die-mirarchi/Watchdog-IHP-SG13G2/design/blocks/bias/README.md

# Polarización analógica

Carpeta reservada. Diseño, dimensiones y arquitectura por definir por el autor.

- `schematic/`: esquemáticos y símbolos Xschem.
- `layout/`: layouts editables y entregables físicos.
- `char/`: configuración de caracterización, cuando exista un diseño.
