die-mirarchi/Watchdog-IHP-SG13G2/graphs/bias/ss/bias_ss_corriente_vs_VDD_y_T.png

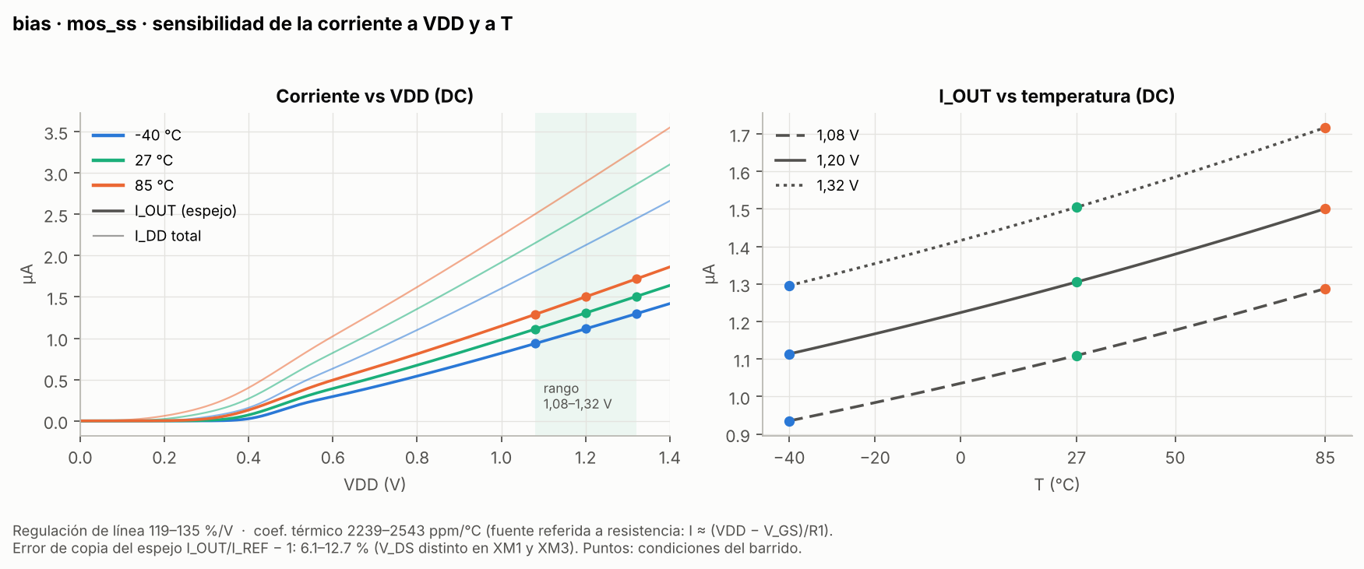
graphs/bias/ss/bias_ss_corriente_vs_VDD_y_T.png
