die-mirarchi/Watchdog-IHP-SG13G2/graphs/bias/ss/bias_ss_corrientes_arranque.png

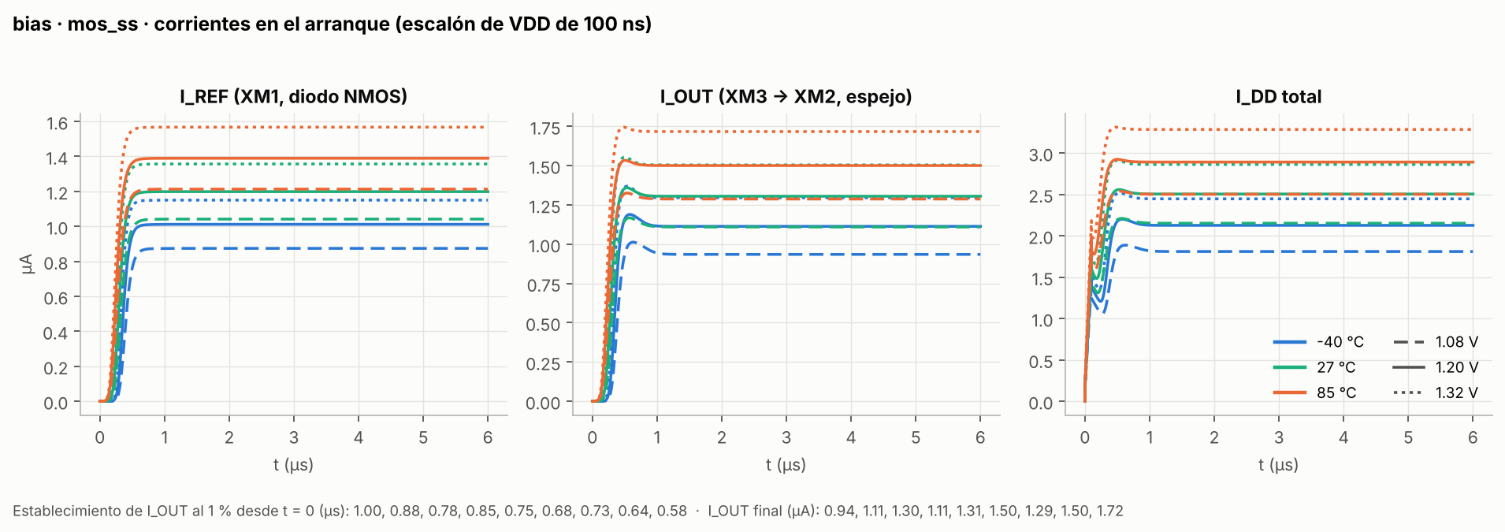
graphs/bias/ss/bias_ss_corrientes_arranque.png
