die-mirarchi/Watchdog-IHP-SG13G2/graphs/comp_inf/ss/comp_inf_ss_respuesta_temporal.png

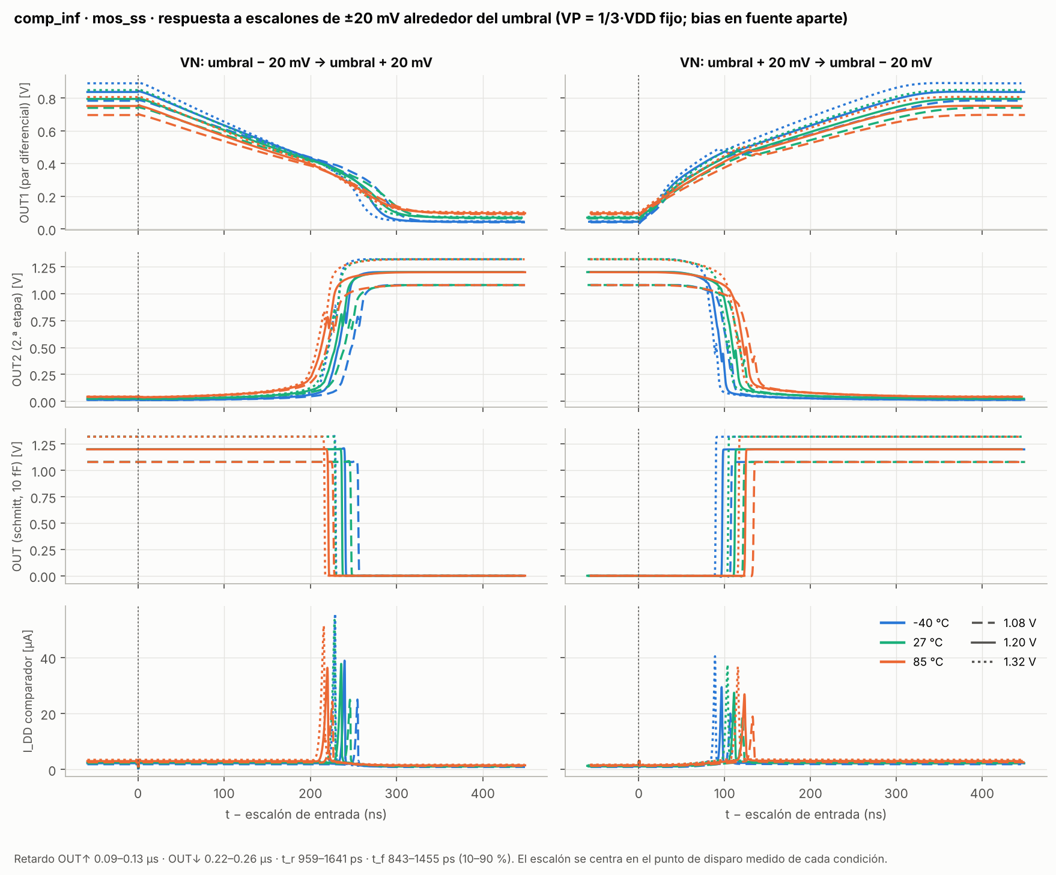
graphs/comp_inf/ss/comp_inf_ss_respuesta_temporal.png
