die-mirarchi/Watchdog-IHP-SG13G2/graphs/comp_inf/tt/comp_inf_tt_respuesta_temporal.png

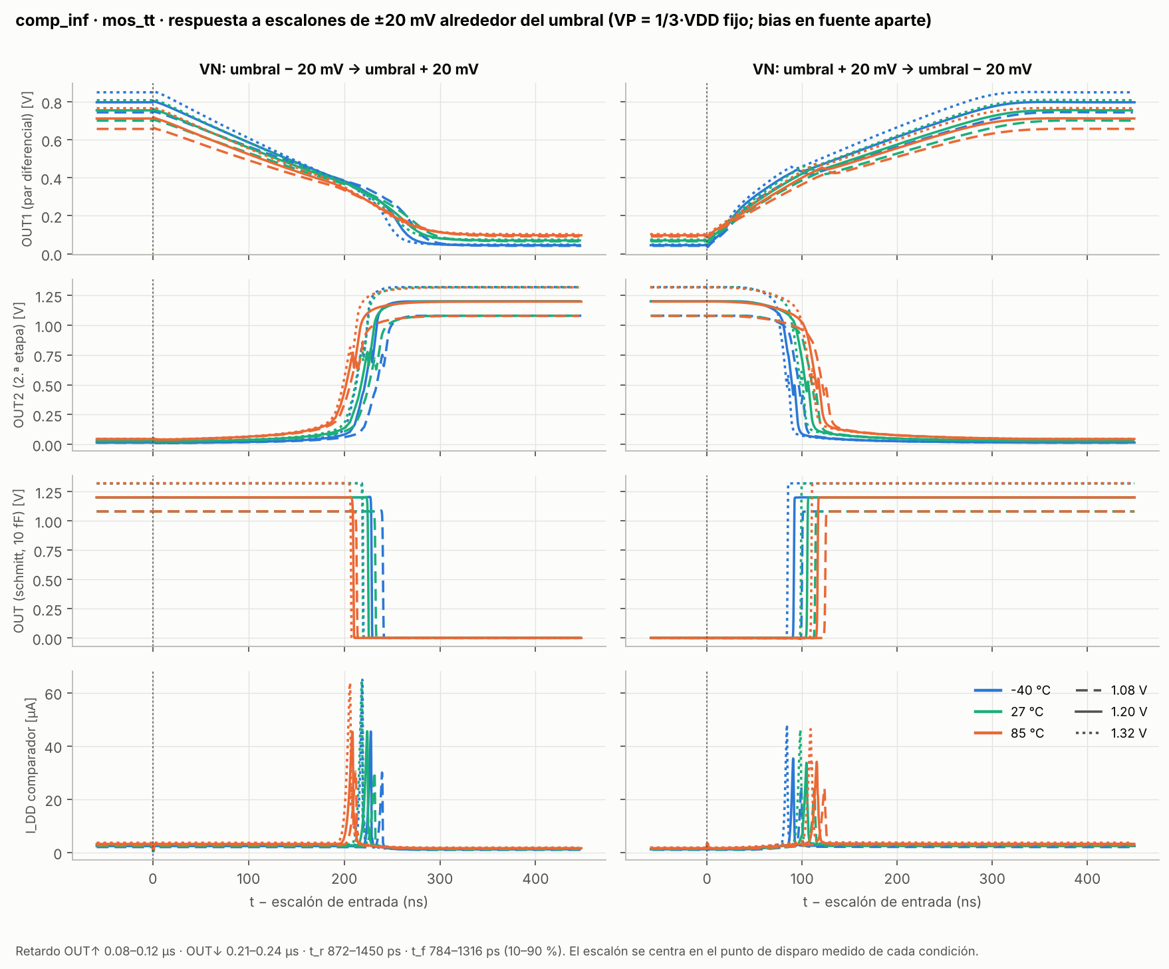
graphs/comp_inf/tt/comp_inf_tt_respuesta_temporal.png
