die-mirarchi/Watchdog-IHP-SG13G2/graphs/comp_sup/ss/comp_sup_ss_respuesta_temporal.png

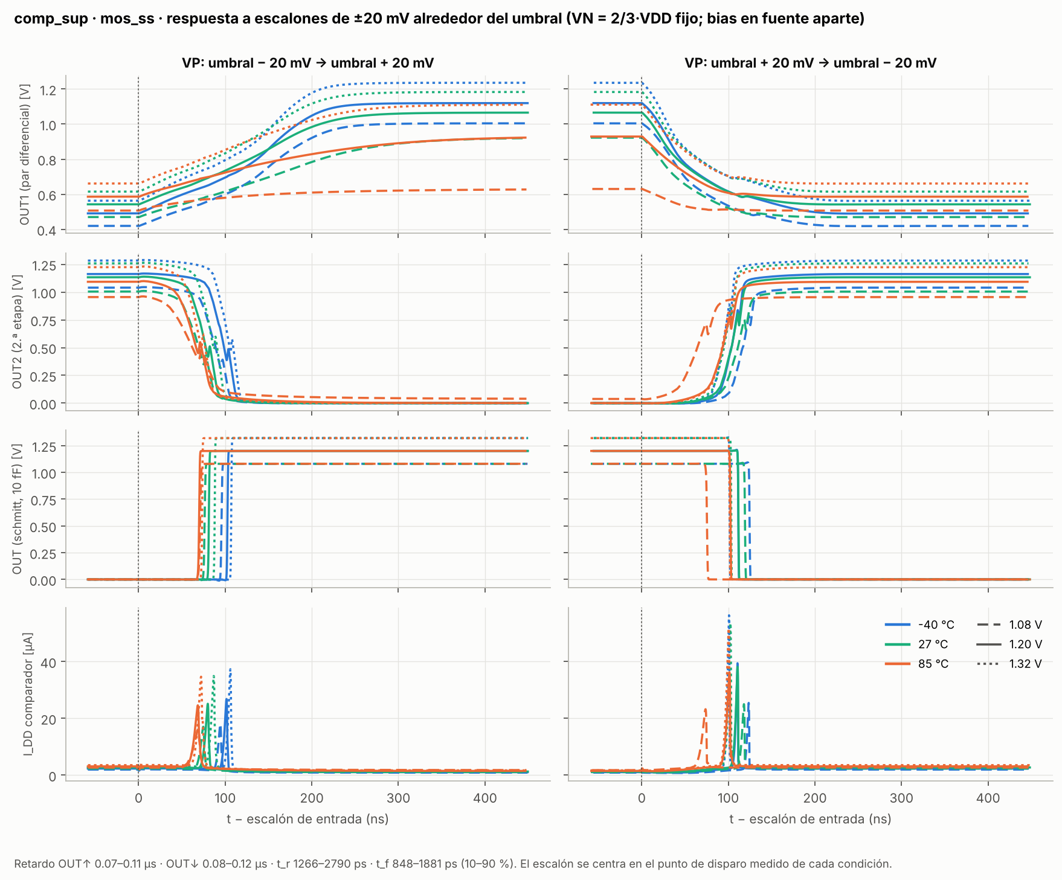
graphs/comp_sup/ss/comp_sup_ss_respuesta_temporal.png
