die-mirarchi/Watchdog-IHP-SG13G2/graphs/comp_sup/ss/comp_sup_ss_umbral.png

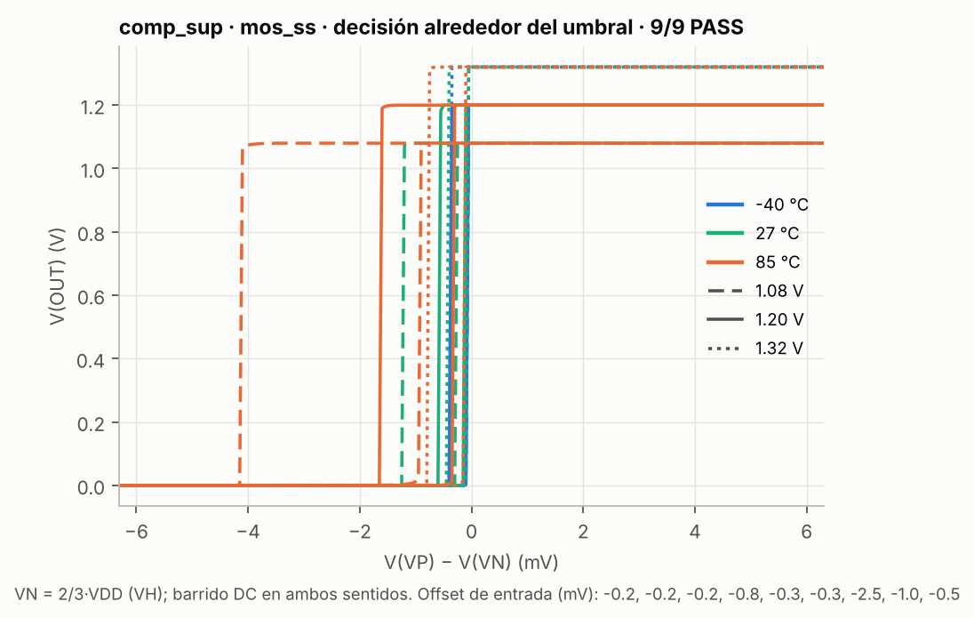
graphs/comp_sup/ss/comp_sup_ss_umbral.png
