die-mirarchi/Watchdog-IHP-SG13G2/graphs/EN_INPUT/ss/EN_INPUT_ss_consumo_y_flancos.png

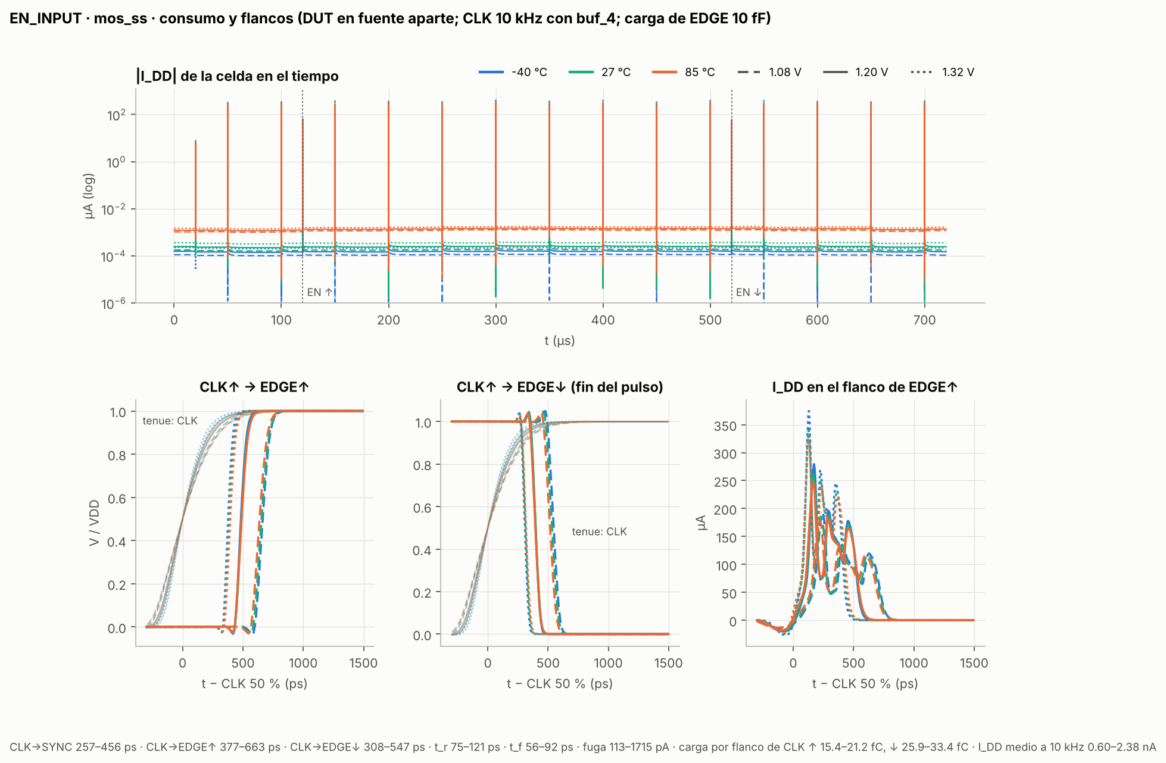
graphs/EN_INPUT/ss/EN_INPUT_ss_consumo_y_flancos.png
