die-mirarchi/Watchdog-IHP-SG13G2/graphs/EN_INPUT/ss/EN_INPUT_ss_deteccion.png

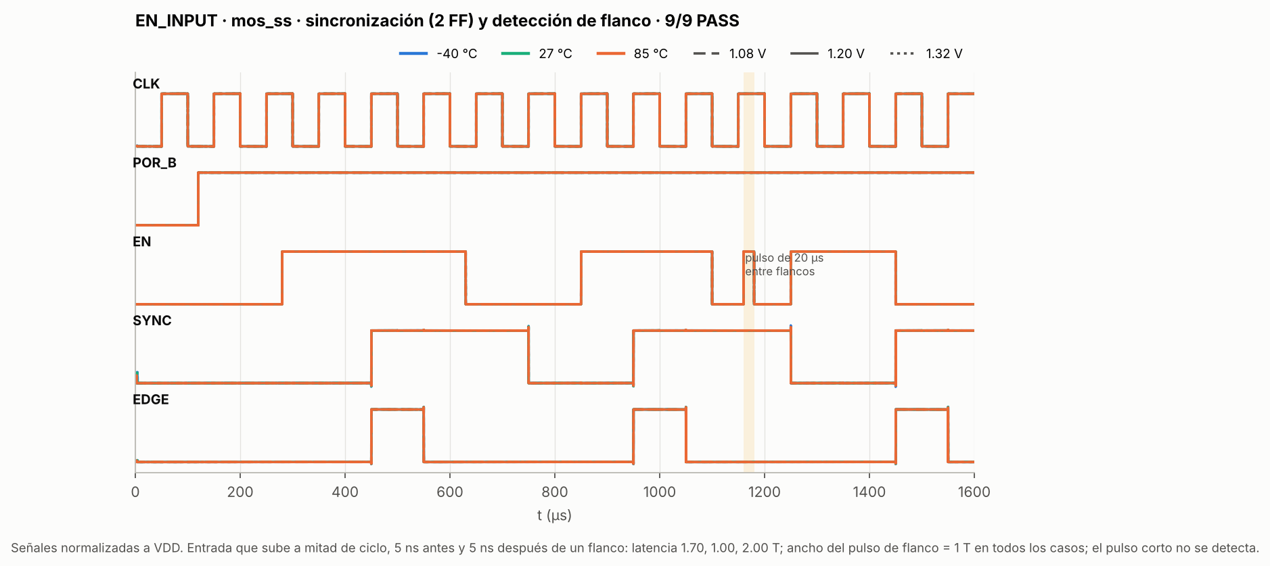
graphs/EN_INPUT/ss/EN_INPUT_ss_deteccion.png
