die-mirarchi/Watchdog-IHP-SG13G2/graphs/EN_INPUT/tt/EN_INPUT_tt_consumo_y_flancos.png

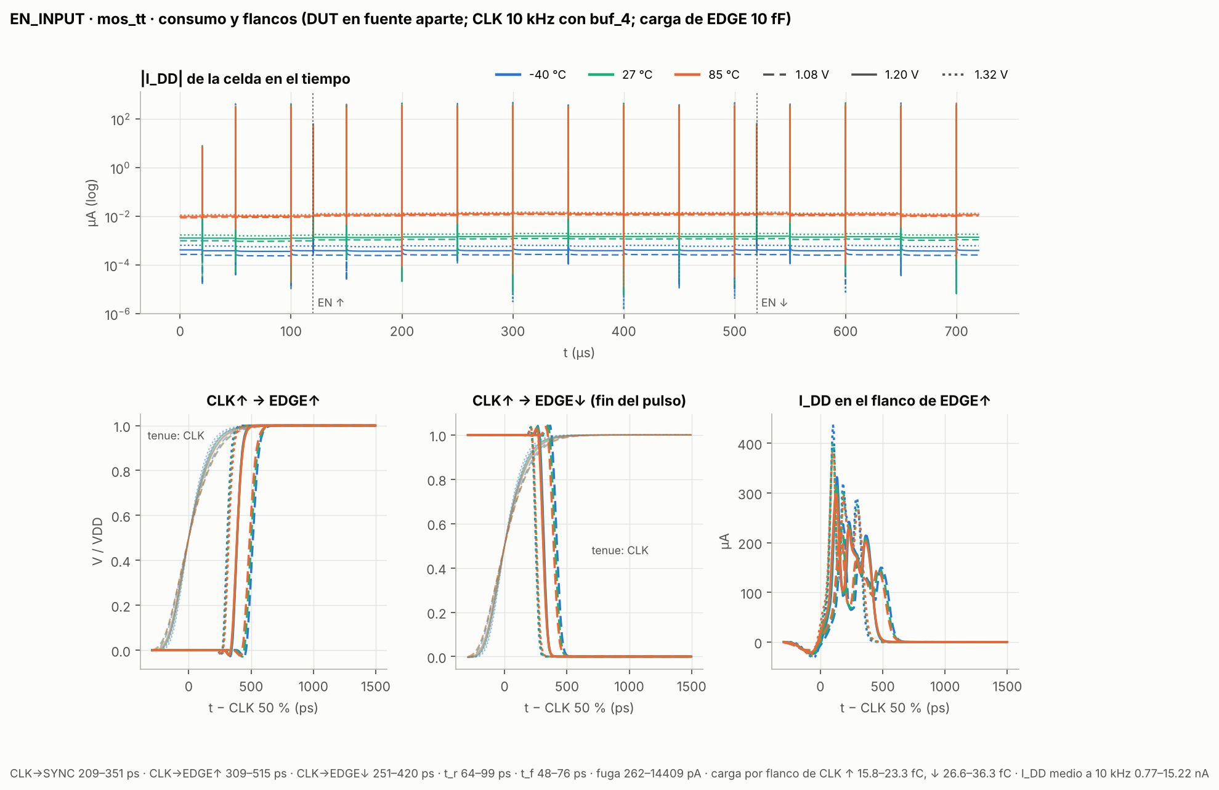
graphs/EN_INPUT/tt/EN_INPUT_tt_consumo_y_flancos.png
