die-mirarchi/Watchdog-IHP-SG13G2/graphs/integracion/ss/integracion_ss.png

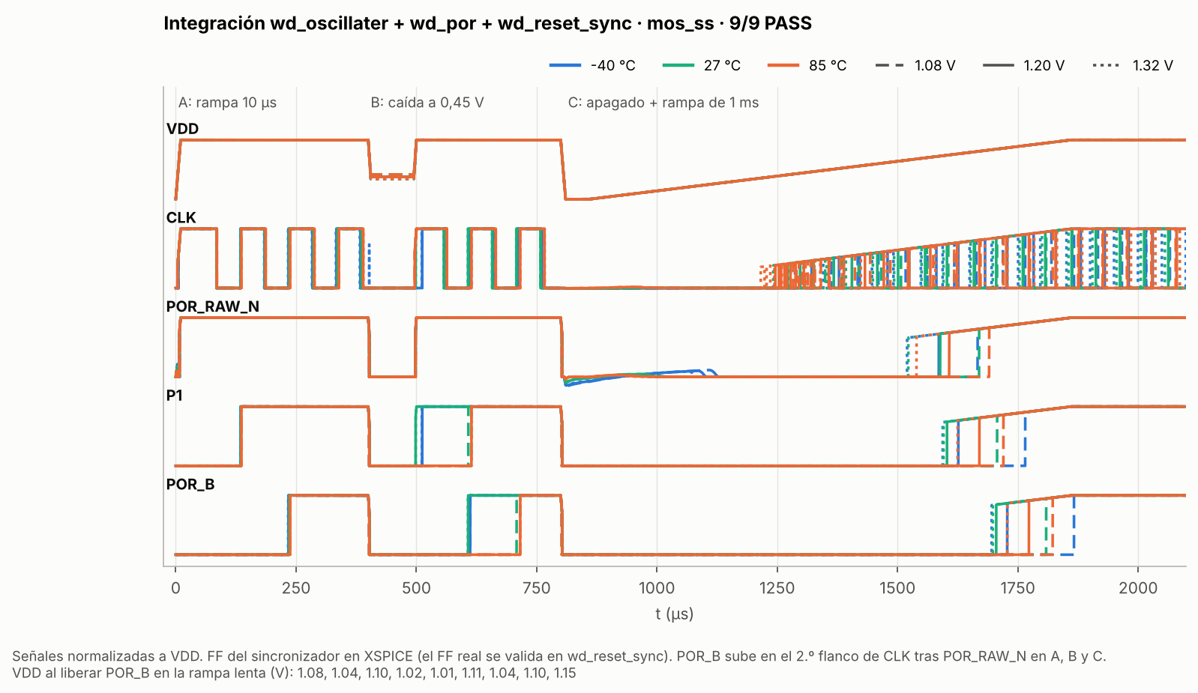
graphs/integracion/ss/integracion_ss.png
