die-mirarchi/Watchdog-IHP-SG13G2/graphs/integracion/ss/integracion_ss_consumo.png

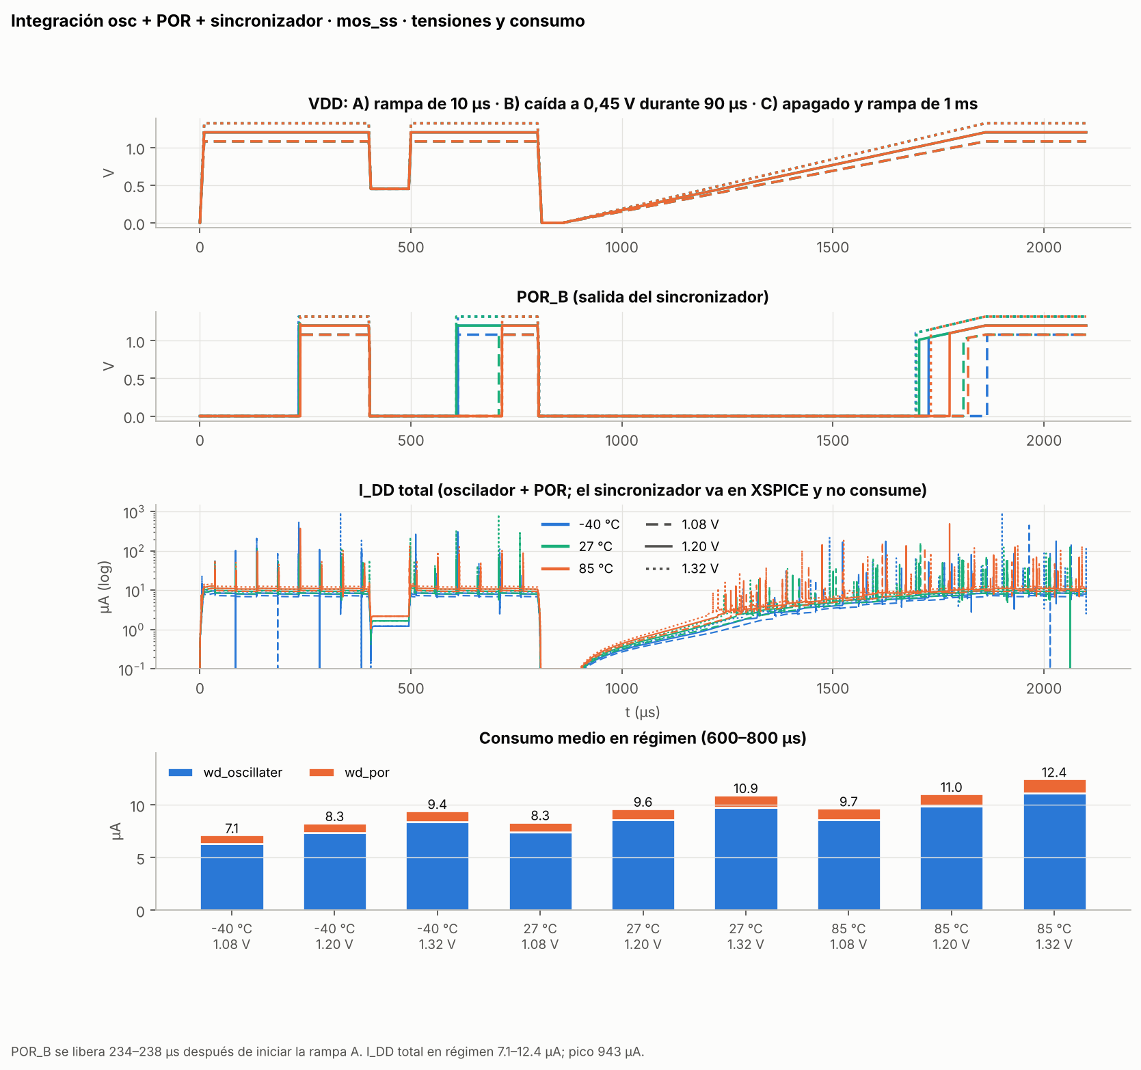
graphs/integracion/ss/integracion_ss_consumo.png
