die-mirarchi/Watchdog-IHP-SG13G2/graphs/integracion/tt/integracion_tt.png

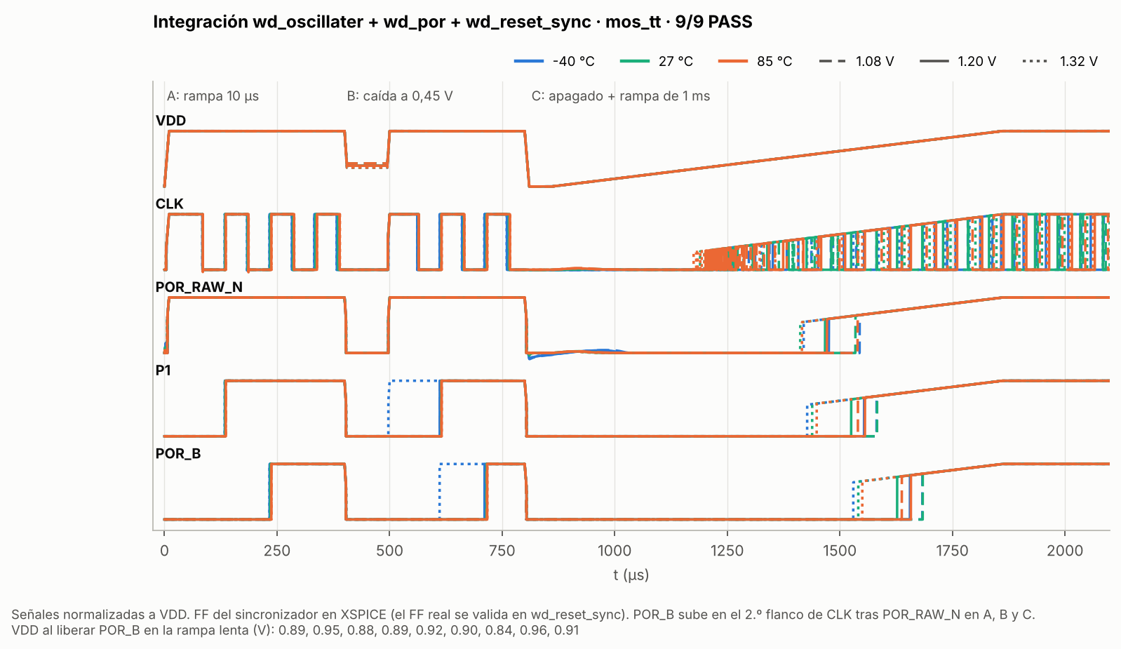
graphs/integracion/tt/integracion_tt.png
