die-mirarchi/Watchdog-IHP-SG13G2/graphs/schmitt/ss/schmitt_ss_conmutacion.png

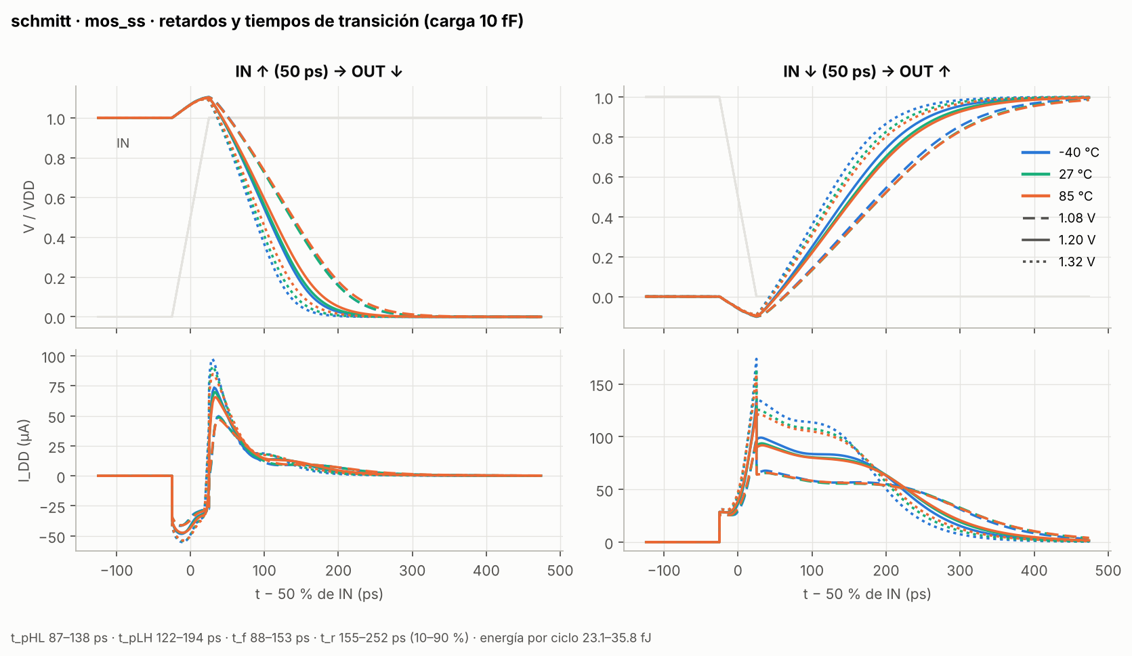
graphs/schmitt/ss/schmitt_ss_conmutacion.png
