die-mirarchi/Watchdog-IHP-SG13G2/graphs/schmitt/ss/schmitt_ss_corriente_DC.png

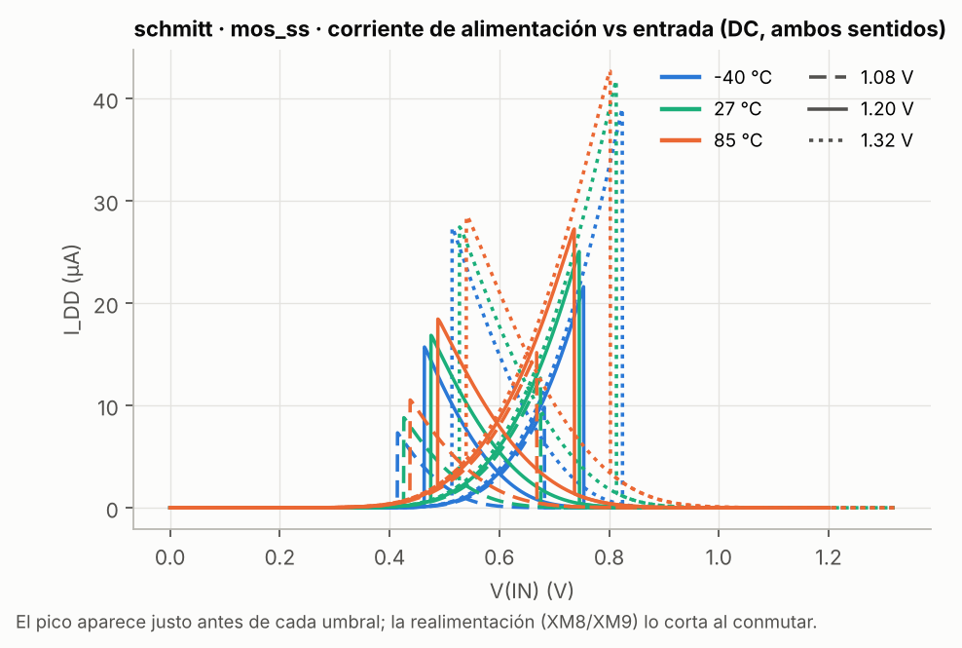
graphs/schmitt/ss/schmitt_ss_corriente_DC.png
