die-mirarchi/Watchdog-IHP-SG13G2/graphs/schmitt/ss/schmitt_ss_histeresis.png

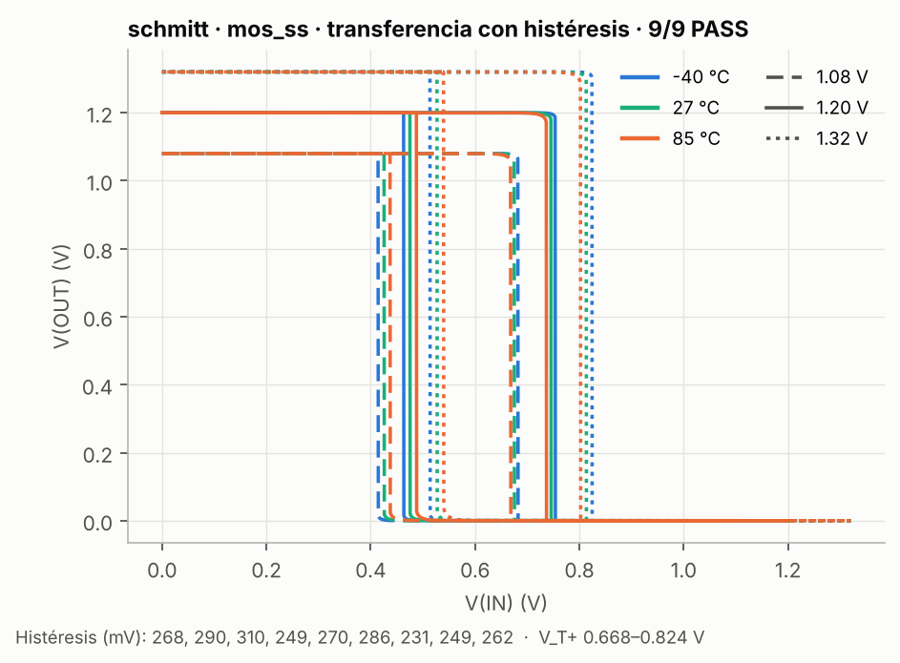
graphs/schmitt/ss/schmitt_ss_histeresis.png
