die-mirarchi/Watchdog-IHP-SG13G2/graphs/schmitt/ss/schmitt_ss_transitorio_y_corriente.png

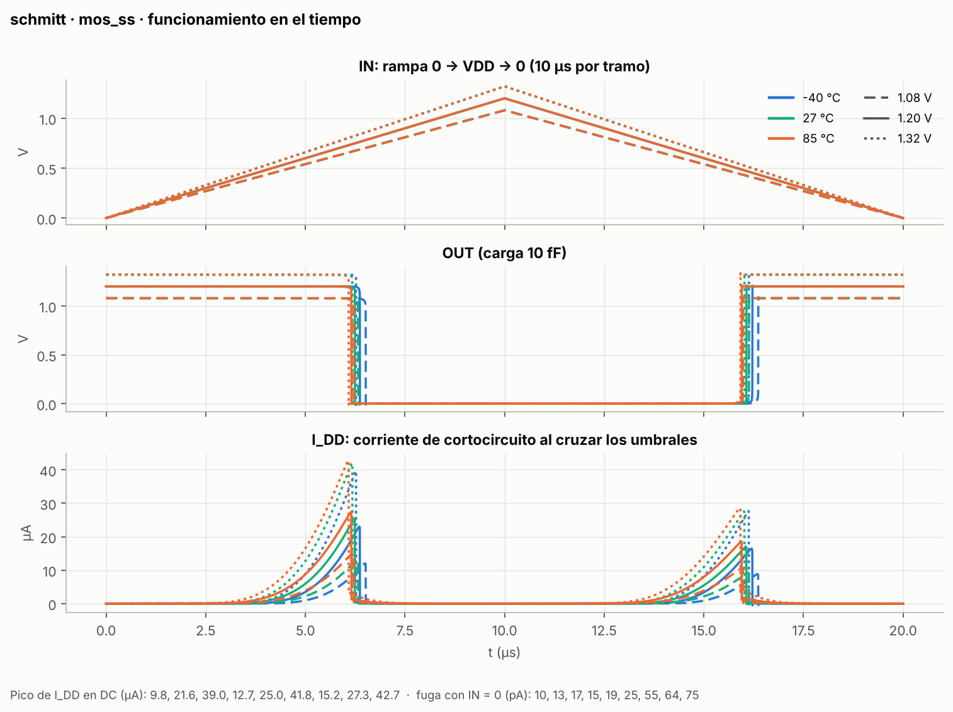
graphs/schmitt/ss/schmitt_ss_transitorio_y_corriente.png
