die-mirarchi/Watchdog-IHP-SG13G2/graphs/schmitt/tt/schmitt_tt_conmutacion.png

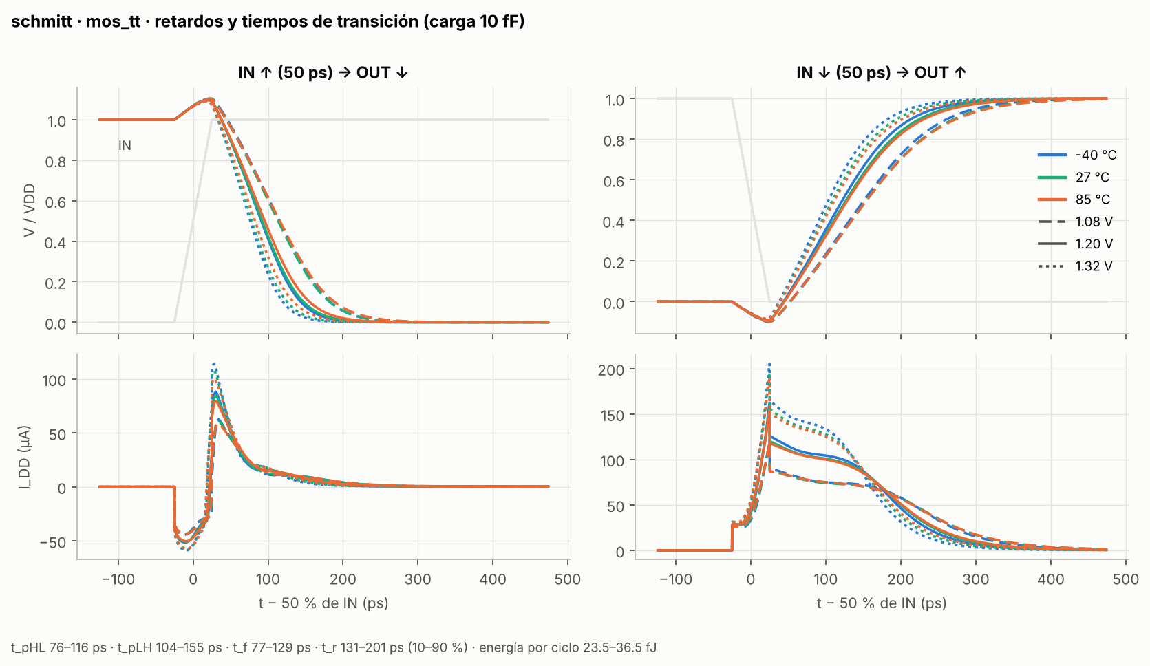
graphs/schmitt/tt/schmitt_tt_conmutacion.png
