die-mirarchi/Watchdog-IHP-SG13G2/graphs/schmitt/tt/schmitt_tt_transitorio_y_corriente.png

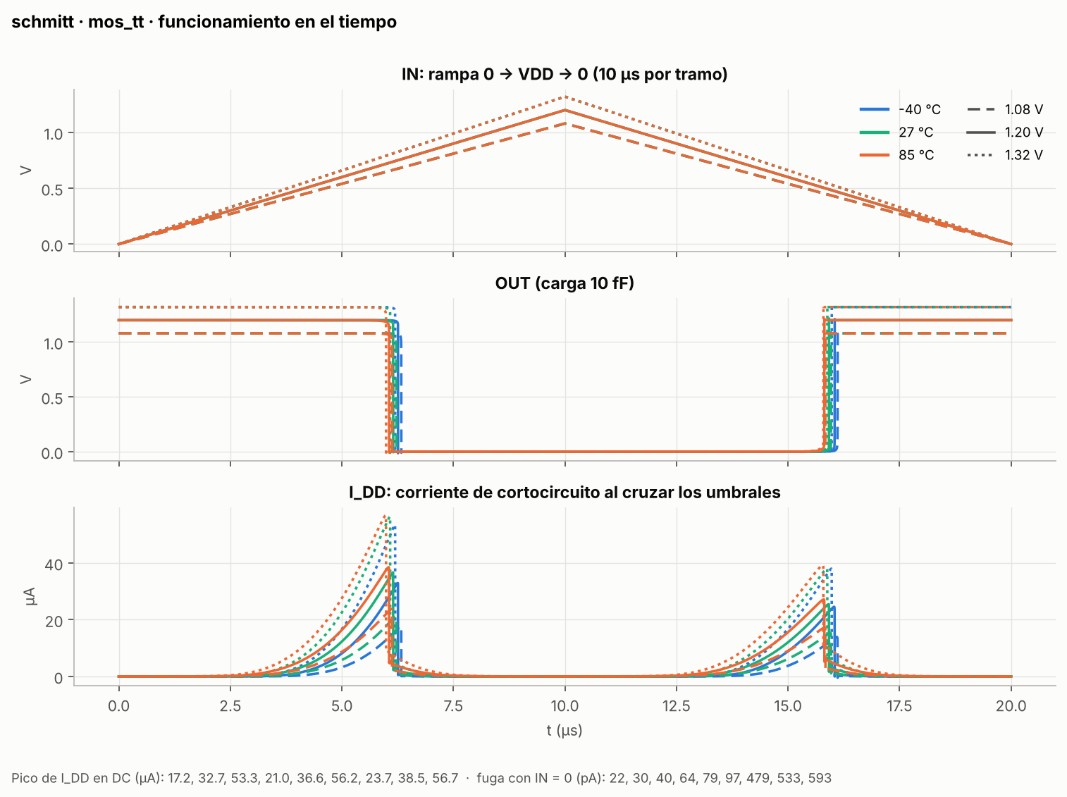
graphs/schmitt/tt/schmitt_tt_transitorio_y_corriente.png
