die-mirarchi/Watchdog-IHP-SG13G2/graphs/wd_oscillater/ss/osc_ss_consumo.png

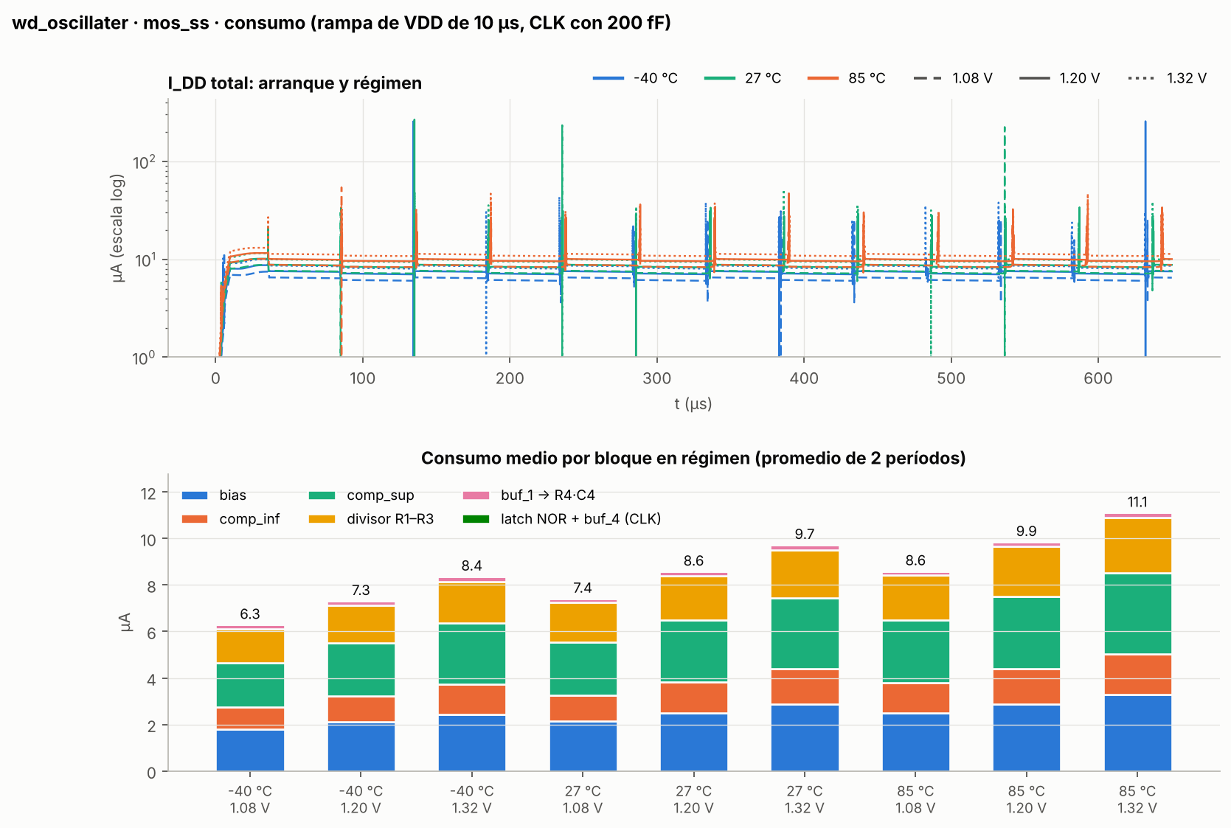
graphs/wd_oscillater/ss/osc_ss_consumo.png
