die-mirarchi/Watchdog-IHP-SG13G2/graphs/wd_oscillater/ss/osc_ss_diagrama_temporal.png

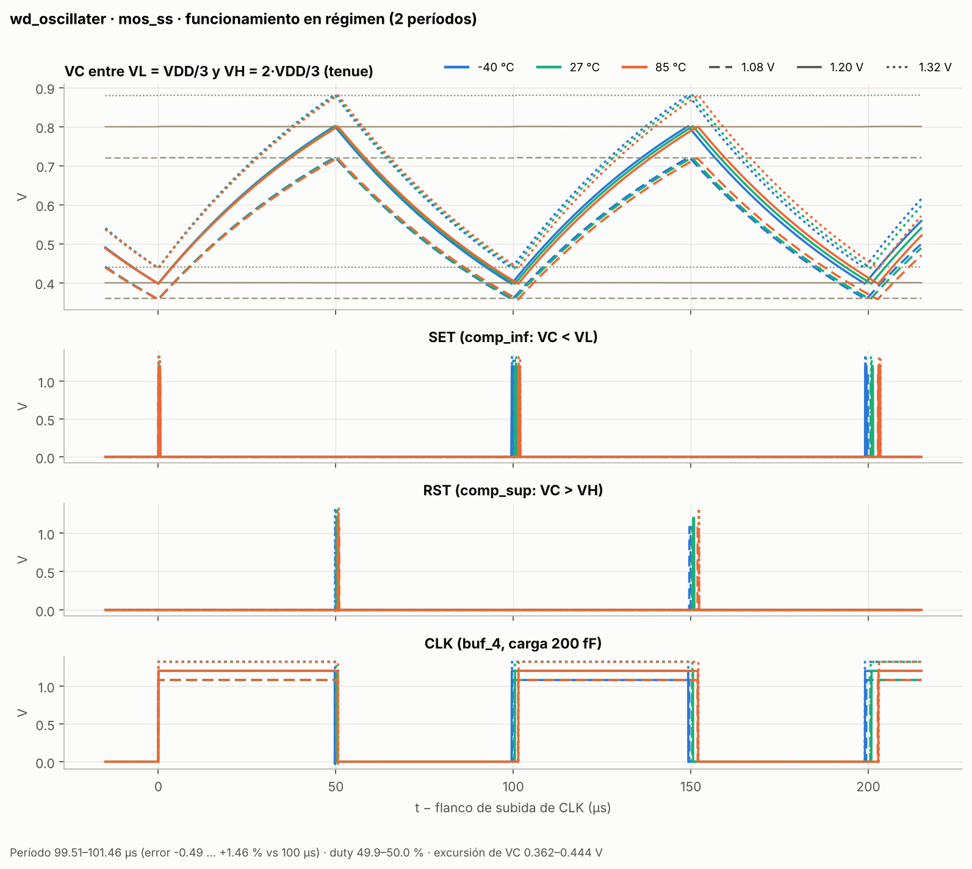
graphs/wd_oscillater/ss/osc_ss_diagrama_temporal.png
