die-mirarchi/Watchdog-IHP-SG13G2/graphs/wd_oscillater/ss/osc_ss_disparo_comparadores.png

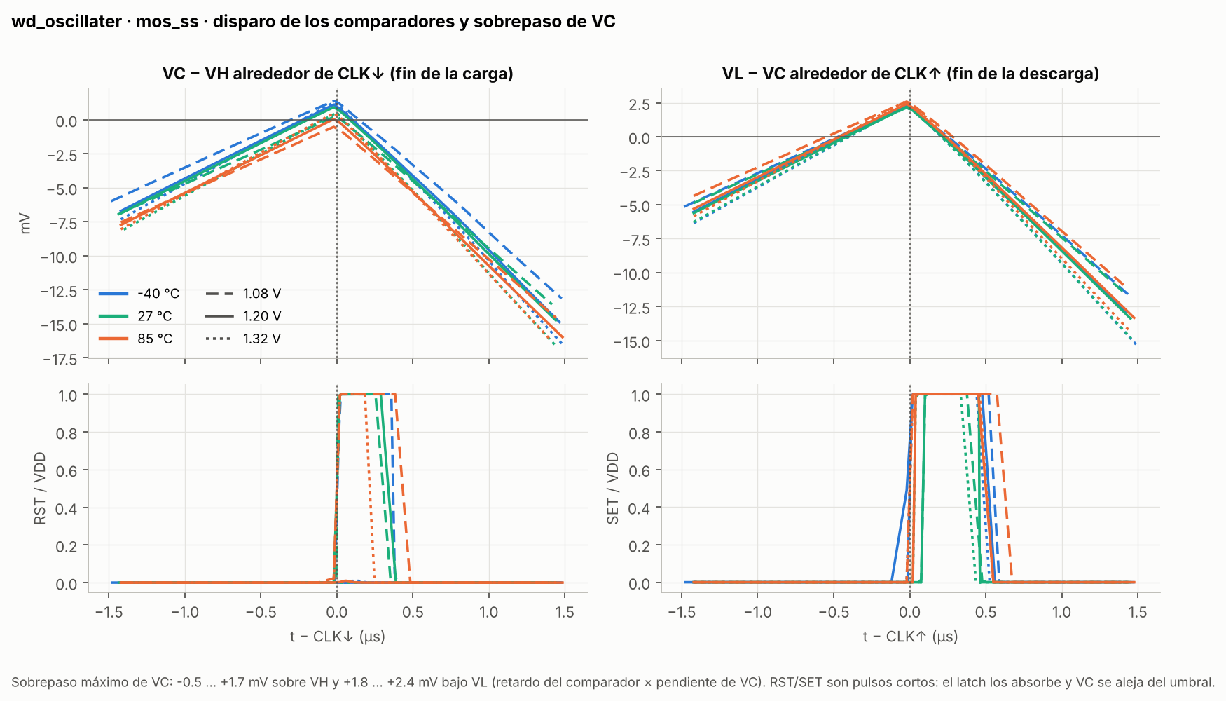
graphs/wd_oscillater/ss/osc_ss_disparo_comparadores.png
