die-mirarchi/Watchdog-IHP-SG13G2/graphs/wd_oscillater/ss/osc_ss_formas_de_onda.png

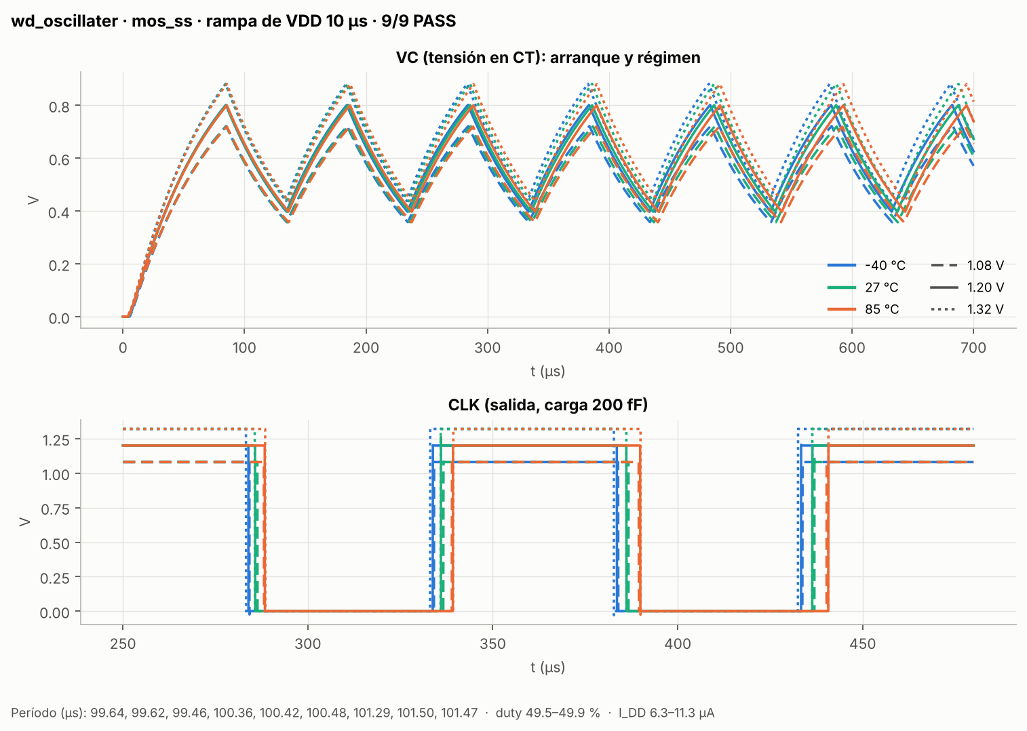
graphs/wd_oscillater/ss/osc_ss_formas_de_onda.png
