die-mirarchi/Watchdog-IHP-SG13G2/graphs/wd_oscillater/tt/osc_tt_flancos_CLK.png

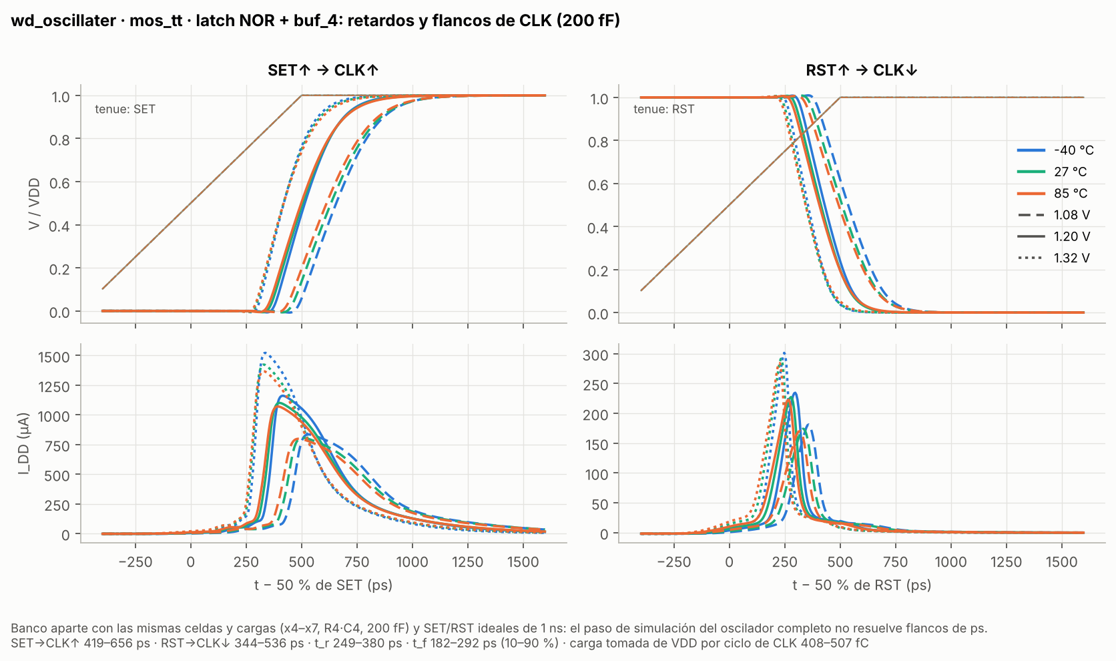
graphs/wd_oscillater/tt/osc_tt_flancos_CLK.png
