die-mirarchi/Watchdog-IHP-SG13G2/graphs/wd_por/ss/por_ss_rampa_rapida_y_corte.png

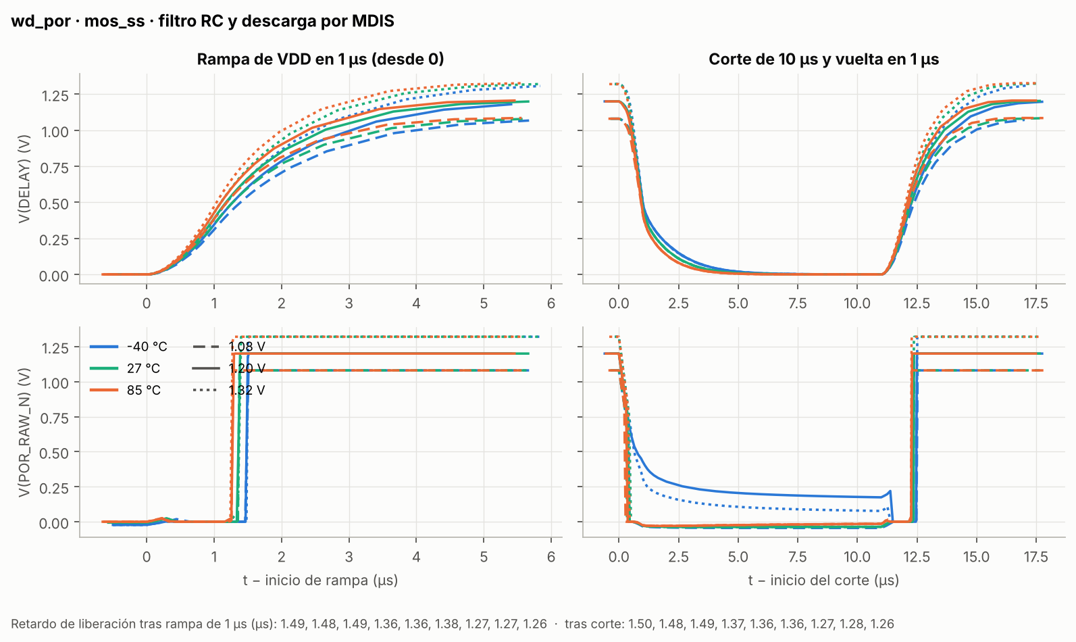
graphs/wd_por/ss/por_ss_rampa_rapida_y_corte.png
