die-mirarchi/Watchdog-IHP-SG13G2/graphs/wd_por/ss/por_ss_resumen.png

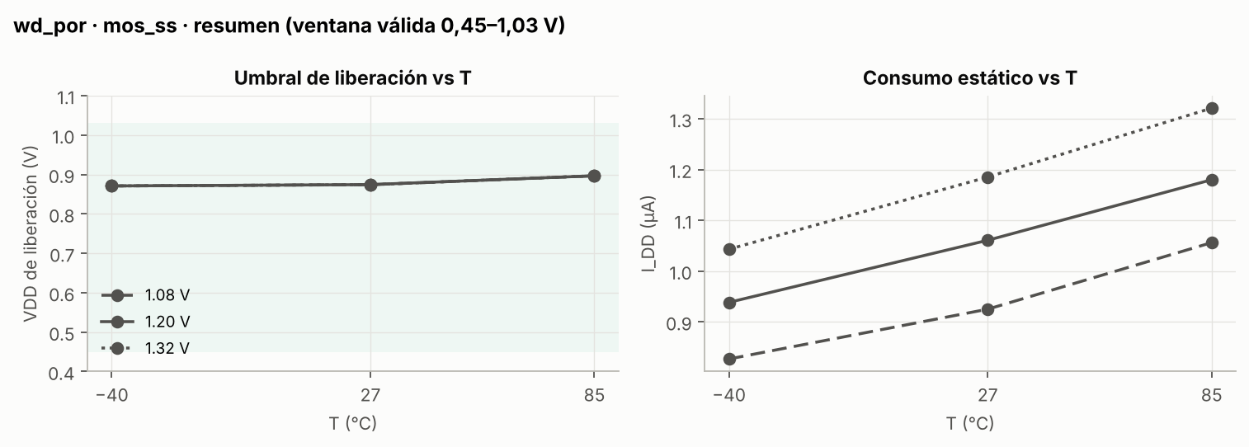
graphs/wd_por/ss/por_ss_resumen.png
