die-mirarchi/Watchdog-IHP-SG13G2/graphs/wd_por/tt/por_tt_corrientes.png

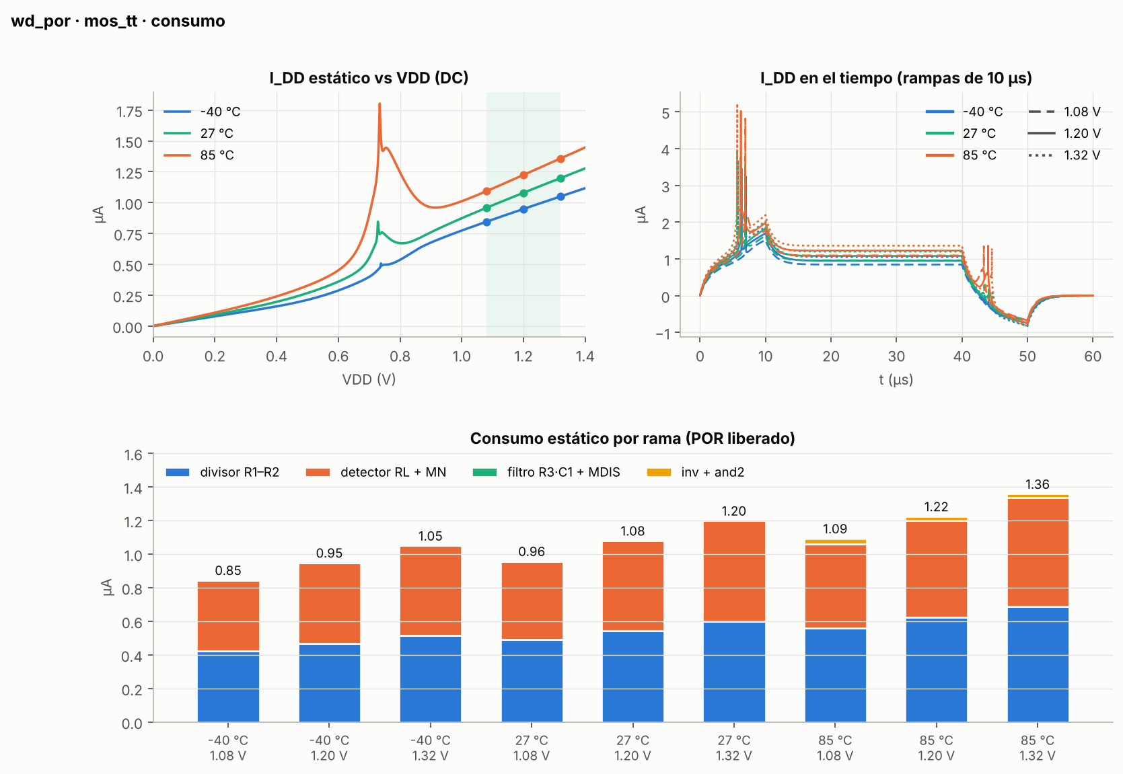
graphs/wd_por/tt/por_tt_corrientes.png
