die-mirarchi/Watchdog-IHP-SG13G2/graphs/wd_reset_sync/ss/rsync_ss_consumo_y_flancos.png

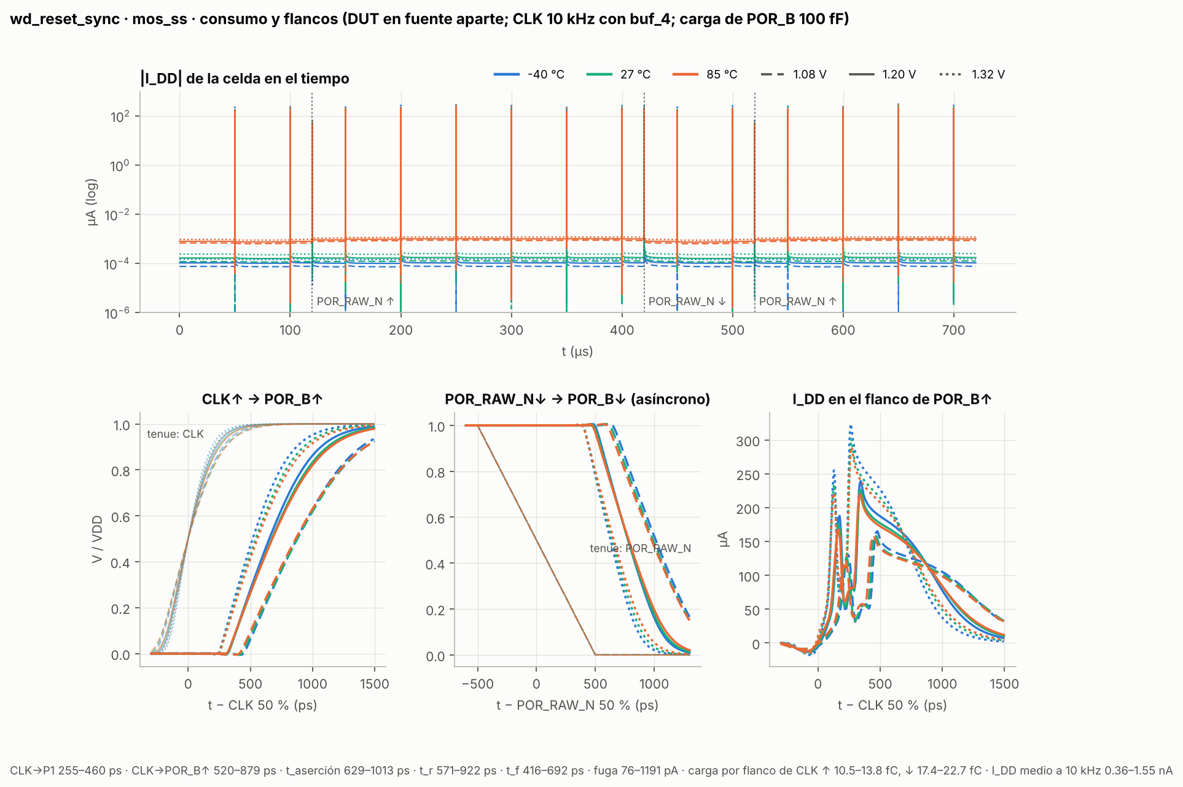
graphs/wd_reset_sync/ss/rsync_ss_consumo_y_flancos.png
