die-mirarchi/Watchdog-IHP-SG13G2/graphs/wd_reset_sync/ss/rsync_ss_retardos.png

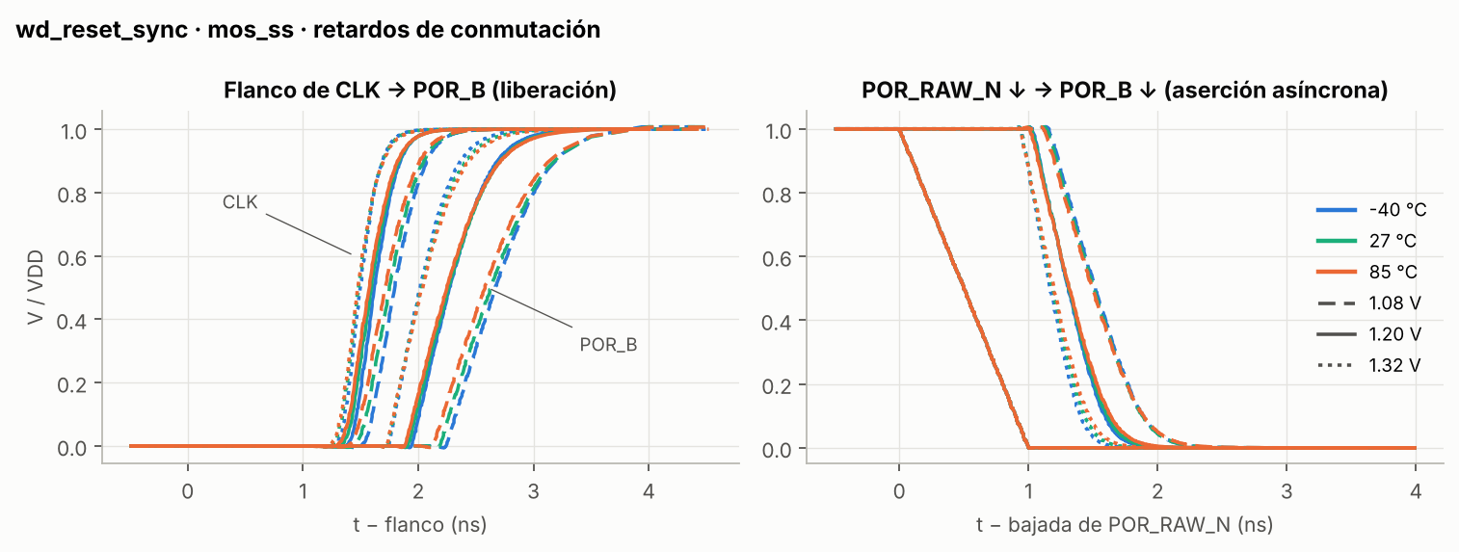
graphs/wd_reset_sync/ss/rsync_ss_retardos.png
