die-mirarchi/Watchdog-IHP-SG13G2/graphs/wd_reset_sync/tt/rsync_tt_consumo_y_flancos.png

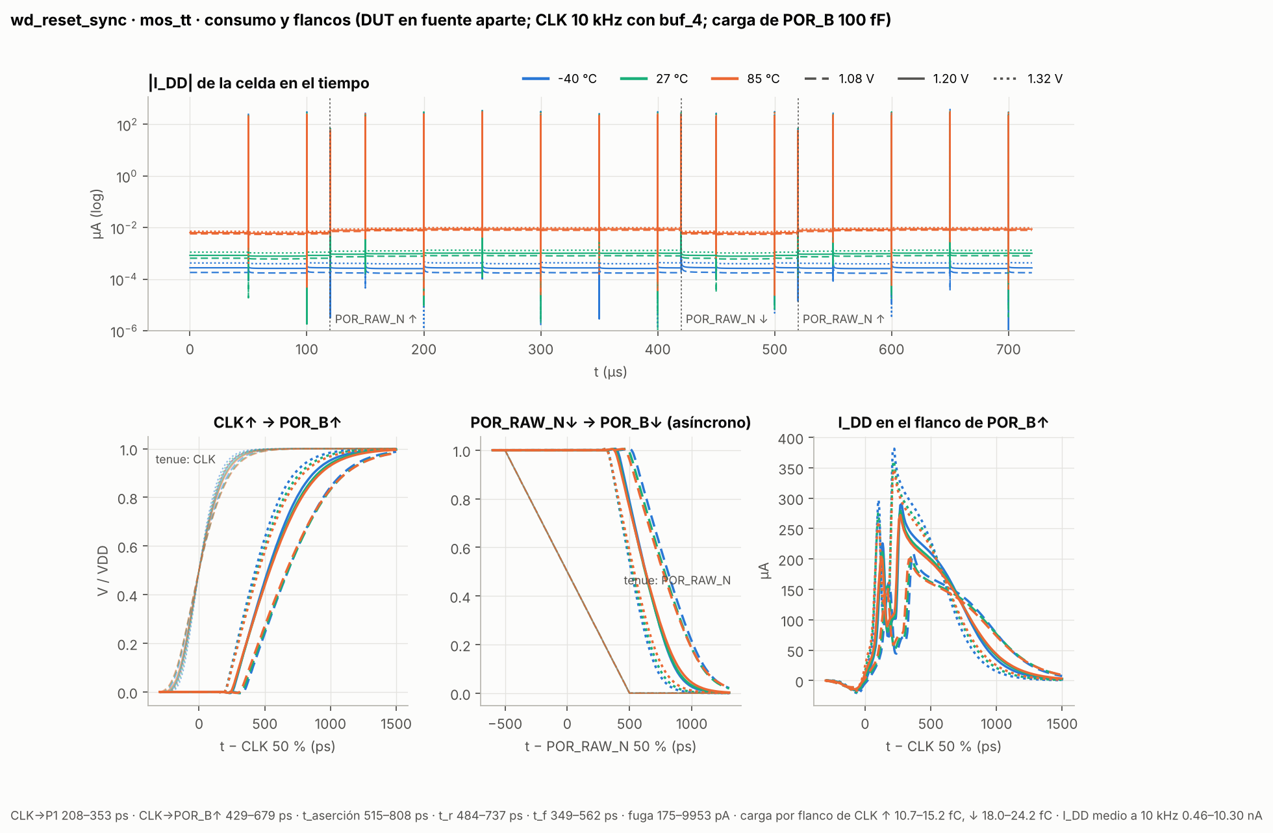
graphs/wd_reset_sync/tt/rsync_tt_consumo_y_flancos.png
