die-mirarchi/Watchdog-IHP-SG13G2/graphs/wd_reset_sync/tt/rsync_tt_retardos.png

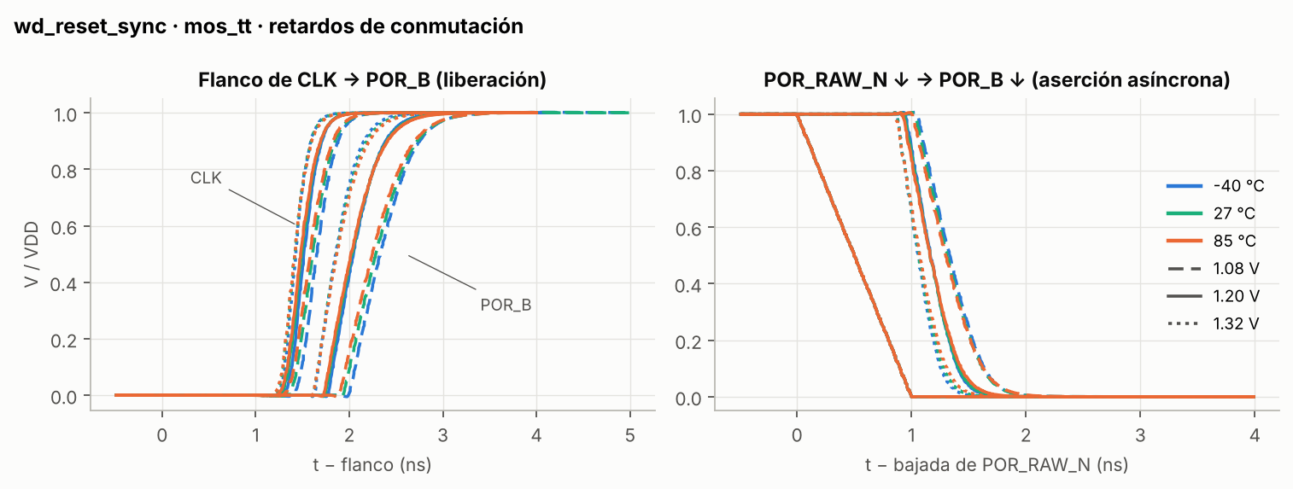
graphs/wd_reset_sync/tt/rsync_tt_retardos.png
