die-mirarchi/Watchdog-IHP-SG13G2/graphs/WDI_INPUT/ss/WDI_INPUT_ss_consumo_y_flancos.png

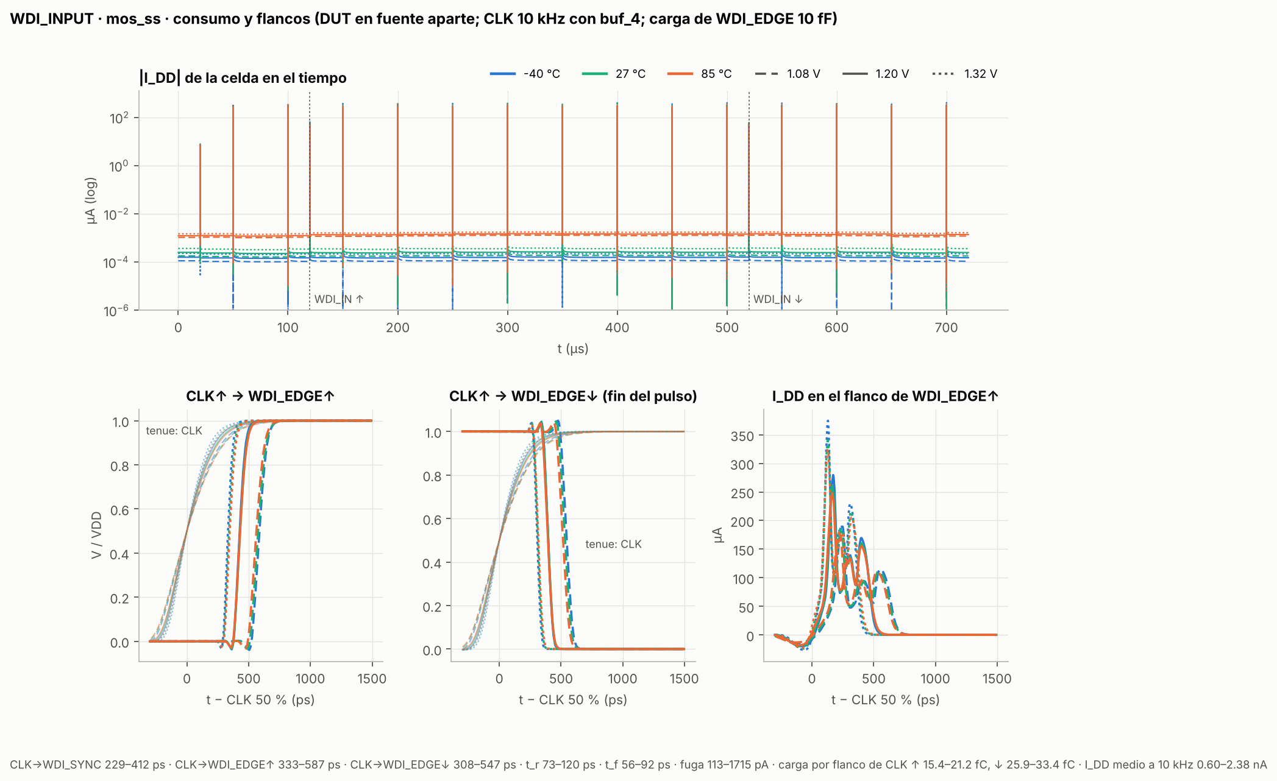
graphs/WDI_INPUT/ss/WDI_INPUT_ss_consumo_y_flancos.png
