die-mirarchi/Watchdog-IHP-SG13G2/graphs/WDI_INPUT/tt/WDI_INPUT_tt_consumo_y_flancos.png

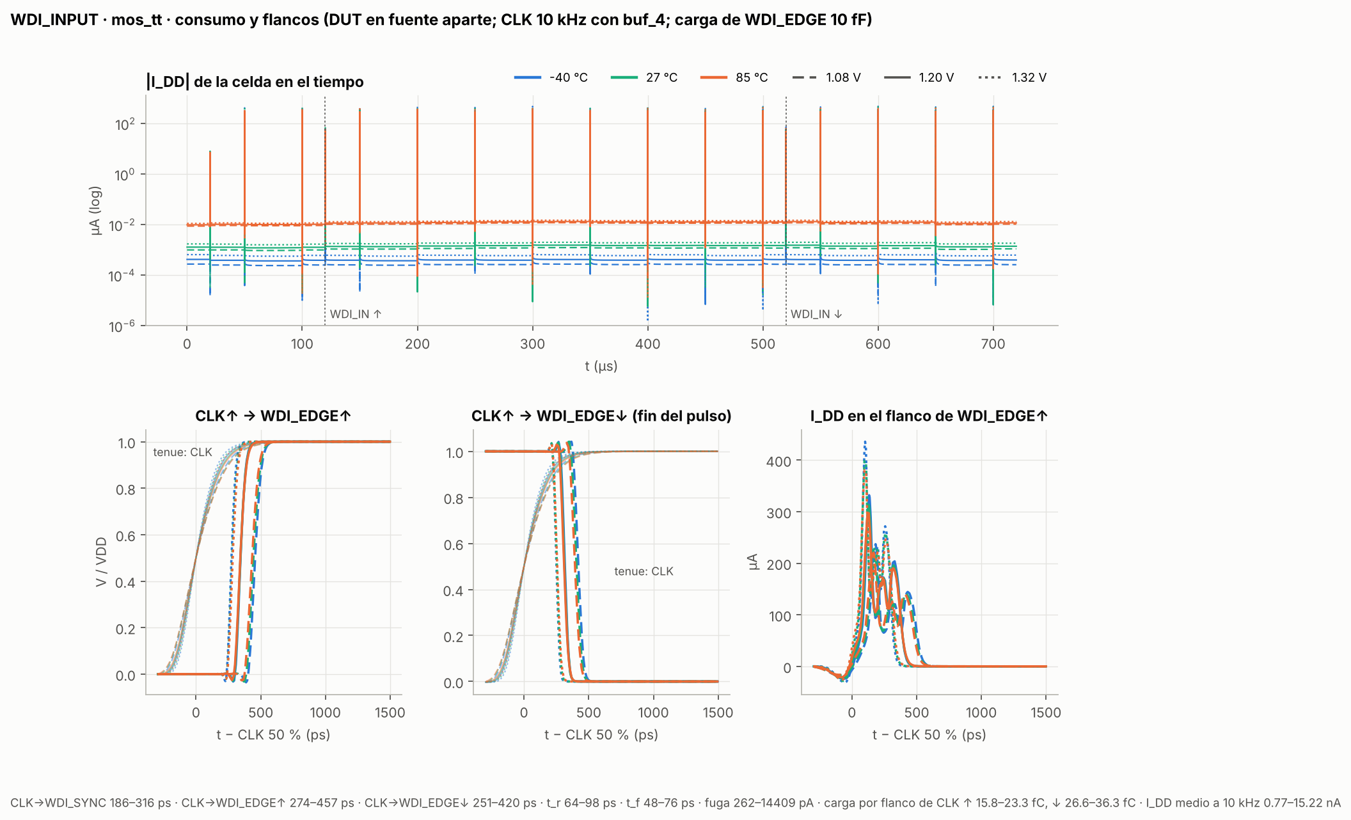
graphs/WDI_INPUT/tt/WDI_INPUT_tt_consumo_y_flancos.png
