die-mirarchi/Watchdog-IHP-SG13G2/design/blocks/digital/schematic/simulation/wd_control_resultados.txt

wd_control -- resultados de verificacion (12/11/2026)
=====================================================
Como se simula (celda digital, secuencial, en lazo con el contador):
 1) Nivel transistor (ngspice, wd_control_tb.sch -> wd_control_tb.spice):
    wd_control real en lazo cerrado con un contador ESCALADO de 6 one_bit:
    T01 = Q1, T00 = Q3&Q2, T10 = Q5&Q4&Q2  -> pulso 3 T, timeouts 13/3/53 T.
    CLK 10 MHz, 21 us; 4 fases (SET = 00, 01, 10, 11) con POR entre cada una.
    Criterio: los 4 pulsos de RESET a +-2 ns de lo esperado, sin quinto pulso,
    ACTIVE/BOOT correctos en 6 instantes.
 2) Logica (Icarus, wd_control_logic_tb.v): lazo con un contador ideal de 17 bits
    y las constantes reales: arranque 102 401 T, pulso 1025 T, timeouts
    10 241 / 1025 / 102 401 T, deshabilitado, WDI en el ultimo ciclo, SET en
    marcha, WDI tras el pulso, POR en marcha.  sh run_logic.sh wd_control

Esquematico del repo (commit 9e7b63d), TAL CUAL:  FAIL
 - ACTIVE no esta conectado a nada que lo maneje: la salida de x14 (nor2,
   NOR(DIS, RESET)) se llama net2 y solo va a x12 (and3). El pin ACTIVE y la
   entrada A2 de x3 (a21o, NBA) quedan flotando: el primer WDI no saca del
   modo arranque y ACTIVE = z. CORRECCION: poner la etiqueta ACTIVE en la
   salida de x14.
 - Icarus: FAIL (ACTIVE = z, BOOT = x tras el primer WDI).
 - ngspice tt/27/1,2: FAIL (1 de 4 pulsos de RESET correctos).

Con esa correccion:
 - Icarus: PASS (constantes reales).
 - ngspice: ver lineas abajo.
   mos_tt 27 C 1,2 V; mos_ss -40 C 1,08 V; mos_tt 85 C 1,32 V: 3/3 PASS
   (4/4 eventos de RESET a +-2 ns, sin quinto pulso, ACTIVE/BOOT correctos).
   ~5 min por caso (2 nucleos); las 9 condiciones de una esquina tardan ~45 min.

ACTUALIZACION (12/11/2026, esquematico corregido: etiqueta ACTIVE en la salida de x14)
 - xschem exporta sin avisos (desaparecio tambien "shorted output node: CLK").
   x14 (nor2) -> ACTIVE -> x12 (and3), x3 (a21o) y pin ACTIVE.
 - Icarus (wd_control_logic_tb.v sobre el netlist exportado): PASS, 36/36 chequeos
   con las constantes reales (arranque 102 401 T, pulso 1025 T, timeouts
   10 241 / 1025 / 102 401 T, deshabilitado, POR en marcha).
 - ngspice con wd_control_tb.spice exportado de xschem (sin modificar):
   mos_tt 9/9 PASS, mos_ss 9/9 PASS (4/4 pulsos de RESET a +-2 ns, sin quinto
   pulso, ACTIVE/BOOT correctos). ~47 min por esquina (9 casos).
