die-mirarchi/Watchdog-IHP-SG13G2/verification/Resumen_validacion_tt_ss.pdf

Watchdog IHP SG13G2 · Resumen de validación tt/ss | pág. 1

# Watchdog IHP SG13G2 — Resumen de validación tt/ss

Repositorio die-mirarchi/Watchdog-IHP-SG13G2, esquemáticos del commit 96250e1 · 06/11/2026 · ngspice 42 + PSP103 (OSDI) · mos_tt y mos_ss, res_typ, cap_typ · T = −40, 27, 85 °C · VDD = 1,08, 1,20, 1,32 V (18 condiciones por celda).

Las 180 corridas de validación funcional pasaron (18/18 por celda). Esta segunda tanda agrega corrientes por bloque, retardos y tiempos de transición. Los consumos de cada celda se midieron con la celda en una fuente propia; los bloques internos del oscilador y del POR, con amperímetros (fuentes de 0 V) en su alimentación. Los flancos se midieron con puntos de simulación densos (20–50 ps) alrededor de cada transición. Los gráficos están en graphs/<celda>/<corner>/.

Convenciones: «típico» = tt, 27 °C, 1,20 V; los rangos cubren las 9 combinaciones de T y VDD de cada corner; «a / b» indica dos magnitudes en la misma fila. Criterios: los usados en los testbenches de validación (o la especificación de la celda cuando existe).

## 1 · Valores clave por celda

Parámetro | Unidad Típico
tt, 27 °C, 1,20 V

tt: mín … máx
(−40/27/85 °C ×
1,08/1,20/1,32 V)
| | | | ss: mín … máx | Criterio

bias — fuente de corriente referida a resistencia

I_REF (XM1, diodo NMOS) | µA | 1,25 | 0,92 … 1,63 | 0,87 … 1,57
I_OUT (espejo XM3 → XM2) | µA | 1,39 | 1,01 … 1,81 | 0,94 … 1,72
I_DD de la celda | µA | 2,64 | 1,93 … 3,44 | 1,81 … 3,28
VBN | V | 0,324 | 0,302 … 0,345 | 0,337 … 0,382 | 0,3–0,7
V_SG del diodo PMOS (VDD − VBP) | V | 0,517 | 0,496 … 0,531 | 0,538 … 0,574 | 0,3–0,75
Error de copia del espejo (I_OUT/I_REF − 1) | % | 11,2 | 8,3 … 15,3 | 6,1 … 12,7
Regulación de línea de I_OUT | %/V | 120 | 114 … 128 | 119 … 135
Coeficiente térmico de I_OUT | ppm/°C 2301 | 2177 … 2456 | 2239 … 2543

Establecimiento al 1 % (escalón de VDD de
100 ns) | µs | 0,66 | 0,38 … 0,87 | 0,58 … 1,00

schmitt — disparador (carga 10 fF)

Umbral de subida V_T+ | V | 0,737 | 0,660 … 0,816 | 0,668 … 0,824
Umbral de bajada V_T− | V | 0,491 | 0,426 … 0,557 | 0,414 … 0,540
Histéresis | mV | 246 | 208 … 284 | 231 … 310 | > 100
Retardo t_pHL / t_pLH (entrada de 50 ps) | ps | 92 / 127 | 76 … 116 / 104 … 155 | 87 … 138 / 122 … 194
Tiempo de bajada t_f / subida t_r (10–90 %) | ps | 98 / 164 | 77 … 129 / 131 … 201 | 88 … 153 / 155 … 252
Pico de I_DD en DC (cortocircuito) | µA | 36,6 | 17,2 … 56,7 | 9,8 … 42,7
Fuga con IN = 0 | pA | 79 | 22 … 593 | 10 … 75
Energía por ciclo completo | fJ | 29,6 | 23,5 … 36,5 | 23,1 … 35,8

comp_sup — comparador (VN = 2/3·VDD, bias real en fuente aparte, carga 10 fF)

Offset de entrada | mV | −0,30 | −1,92 … −0,20 | −2,53 … −0,22 | |x| < 10

Histéresis de disparo (barrido en ambos
sentidos) | mV | 0,35 | 0,25 … 2,30 | 0,30 … 3,20 | < 5
Corriente de cola | µA | 1,34 | 0,96 … 1,77 | 0,89 … 1,67
I_DD en reposo, OUT alto | µA | 1,36 | 0,97 … 1,78 | 0,90 … 1,77
I_DD en reposo, OUT bajo | µA | 2,87 | 2,11 … 3,70 | 1,97 … 3,52
Retardo OUT↑ (escalón de ±20 mV) | ns | 81 | 68 … 106 | 70 … 107
Retardo OUT↓ (escalón de ±20 mV) | ns | 107 | 85 … 116 | 75 … 125
t_r / t_f de OUT (10–90 %) | ns | 1,43 / 1,01 | 1,13 … 2,20 / 0,79 … 1,56 1,27 … 2,79 / 0,85 … 1,88
Pico de I_DD al cruzar el umbral (DC) | µA | 20,2 | 13,2 … 40,3 | 7,0 … 31,3

comp_inf — comparador (VP = 1/3·VDD, bias real en fuente aparte, carga 10 fF)

Offset de entrada | mV | −0,07 | −0,10 … −0,05 | −0,10 | |x| < 10

Histéresis de disparo (barrido en ambos
sentidos) | mV | 0,00 | 0,00 … 0,05 | 0,05 | < 5
Corriente de cola | µA | 1,38 | 1,00 … 1,81 | 0,92 … 1,71

Parámetro | Unidad Típico
tt, 27 °C, 1,20 V

tt: mín … máx
(−40/27/85 °C ×
1,08/1,20/1,32 V)
| | | | ss: mín … máx | Criterio
I_DD en reposo, OUT alto | µA | 2,79 | 2,03 … 3,65 | 1,87 … 3,45
I_DD en reposo, OUT bajo | µA | 1,39 | 1,00 … 1,85 | 0,92 … 1,73
Retardo OUT↑ (escalón de ±20 mV) | ns | 106 | 85 … 124 | 90 … 134
Retardo OUT↓ (escalón de ±20 mV) | ns | 225 | 207 … 241 | 216 … 256
t_r / t_f de OUT (10–90 %) | ns | 1,13 / 1,00 | 0,87 … 1,45 / 0,78 … 1,32 0,96 … 1,64 / 0,84 … 1,45
Pico de I_DD al cruzar el umbral (DC) | µA | 12,9 | 2,5 … 58,8 | 5,2 … 19,5

wd_oscillater — oscilador de relajación (CLK con carga 200 fF)

Período | µs | 100,47 | 99,43 … 101,47 | 99,51 … 101,46 | 80–120
Error de período respecto de 100 µs | % | 0,47 | −0,57 … 1,47 | −0,49 … 1,46 | ± 20
Ciclo de trabajo | % | 50,0 | 49,9 … 50,0 | 49,9 … 50,0 | 45–55
Primer flanco de CLK desde el inicio de la rampa | µs | 135,0 | 133,7 … 136,1 | 134,2 … 136,3 | < 150
Excursión de VC (VH − VL efectiva) | V | 0,403 | 0,362 … 0,444 | 0,362 … 0,444
Sobrepaso de VC sobre VH / bajo VL | mV | 1,1 / 2,0 | −0,5 … 1,7 / 1,7 … 2,5 | −0,5 … 1,7 / 1,8 … 2,4

Retardo RST↑ → CLK↓ / SET↑ → CLK↑ (latch
+ buf_4) | ps | 413 / 505 | 344 … 536 / 419 … 656 | 415 … 640 / 502 … 815
t_r / t_f de CLK (10–90 %) | ps | 310 / 227 | 249 … 380 / 182 … 292 | 292 … 474 / 215 … 359
I_DD medio en régimen | µA | 8,97 | 6,64 … 11,60 | 6,29 … 11,11

Pico de I_DD en un flanco de CLK (latch +
buf_4) | µA | 1100 | 798 … 1523 | 629 … 1278

Carga tomada de VDD por ciclo de CLK
(latch + buffers) | fC | 455 | 408 … 507 | 406 … 500

wd_por — detector de nivel + filtro RC

VDD de liberación (rampa de 1 ms) | V | 0,729 | 0,728 … 0,739 | 0,871 … 0,897 | 0,45–1,03
VDD de aserción (bajada de 1 ms) | V | 0,728 | 0,728 … 0,738 | 0,870 … 0,896 | 0,45–1,03
Umbral DC de VOK | V | 0,728 | 0,728 … 0,738 | 0,870 … 0,896
Margen hasta VDD mín. (1,08 V − liberación) mV | 351 | 341 … 352 | 183 … 209 | > 50
Retardo tras rampa de 1 µs (filtro R3·C1) | µs | 1,36 | 1,28 … 1,52 | 1,26 … 1,49 | > 1
Retardo tras corte de 10 µs | µs | 1,36 | 1,28 … 1,52 | 1,26 … 1,50 | ≥ 0,8 × (1
| | | | | µs)
Liberación con rampa de 10 µs (desde t = 0) µs | 6,21 | 5,65 … 7,02 | 6,76 … 8,42

t_r de POR_RAW_N/VDD (10–90 %, carga 10
fF) | ns | 4,27 | 3,80 … 4,51 | 2,99 … 3,74
I_DD estático (POR liberado) | µA | 1,08 | 0,85 … 1,36 | 0,83 … 1,32 | < 2
Pico de I_DD durante el arranque | µA | 3,8 | 3,2 … 5,2 | 4,0 … 6,9

wd_reset_sync — sincronizador de reset (2 × dfrbp_1, POR_B con 100 fF)

Latencia de liberación (8 fases de
POR_RAW_N) | ciclos | 1,00 / 2,00 | 1,00 / 2,00 | 1,00 / 2,00 | 1–2
CLK↑ → P1↑ | ps | 259 | 208 … 353 | 255 … 460
CLK↑ → POR_B↑ | ps | 536 | 429 … 679 | 520 … 879 | < 20 ns
POR_RAW_N↓ → POR_B↓ (asíncrono) | ps | 625 | 515 … 808 | 629 … 1013 | < 100 ns
t_r / t_f de POR_B (10–90 %) | ps | 602 / 436 | 484 … 737 / 349 … 562 | 571 … 922 / 416 … 692
Fuga entre flancos | pA | 1017 | 175 … 9953 | 76 … 1191
Carga por flanco de CLK (↑ / ↓) | fC | 12,4 / 20,8 | 10,7 … 15,2 / 18,0 … 24,2 10,5 … 13,8 / 17,4 … 22,7
I_DD medio a 10 kHz | nA | 1,35 | 0,46 … 10,30 | 0,36 … 1,55

EN_INPUT — sincronizador (2 FF) + detector de flanco (EDGE con 10 fF)

Latencia entrada → flanco (mitad de ciclo,
±5 ns del flanco) | ciclos | 1,00 / 2,00 | 1,00 / 2,00 | 1,00 / 2,00 | 1–2
Ancho del pulso EDGE | ciclos | 1,0000 | 1,0000 | 1,0000 | 1
CLK↑ → SYNC↑ | ps | 262 | 209 … 351 | 257 … 456
CLK↑ → EDGE↑ / CLK↑ → EDGE↓ | ps | 389 / 313 | 309 … 515 / 251 … 420 | 377 … 663 / 308 … 547
t_r / t_f de EDGE (10–90 %) | ps | 79 / 60 | 64 … 99 / 48 … 76 | 75 … 121 / 56 … 92

Parámetro | Unidad Típico
tt, 27 °C, 1,20 V

tt: mín … máx
(−40/27/85 °C ×
1,08/1,20/1,32 V)
| | | | ss: mín … máx | Criterio
Fuga entre flancos | pA | 1480 | 262 … 14409 | 113 … 1715
I_DD medio a 10 kHz | nA | 2,09 | 0,77 … 15,22 | 0,60 … 2,38

WDI_INPUT — sincronizador (2 FF) + detector de flanco (WDI_EDGE con 10 fF)

Latencia entrada → flanco (mitad de ciclo,
±5 ns del flanco) | ciclos | 1,00 / 2,00 | 1,00 / 2,00 | 1,00 / 2,00 | 1–2
Ancho del pulso WDI_EDGE | ciclos | 1,0000 | 1,0000 | 1,0000 | 1
CLK↑ → WDI_SYNC↑ | ps | 233 | 186 … 316 | 229 … 412
CLK↑ → WDI_EDGE↑ / CLK↑ → WDI_EDGE↓ | ps | 344 / 313 | 274 … 457 / 251 … 420 | 333 … 587 / 308 … 547
t_r / t_f de WDI_EDGE (10–90 %) | ps | 79 / 60 | 64 … 98 / 48 … 76 | 73 … 120 / 56 … 92
Fuga entre flancos | pA | 1480 | 262 … 14409 | 113 … 1715
I_DD medio a 10 kHz | nA | 2,09 | 0,77 … 15,22 | 0,60 … 2,38

Integración wd_oscillater + wd_por + wd_reset_sync (FF en XSPICE)

VDD al liberar POR_RAW_N (rampa de 1 ms) | V | 0,728 | 0,728 … 0,739 | 0,871 … 0,897
VDD al liberar POR_B (rampa de 1 ms) | V | 0,920 | 0,840 … 0,957 | 1,014 … 1,146 | ver § 3

Latencia POR_RAW_N → POR_B (rampa de 10
µs) | ciclos | 2,28 | 2,28 … 2,29 | 2,26 … 2,28 | 1–3

POR_B liberado desde el inicio de la rampa
de 10 µs | µs | 235 | 233 … 238 | 234 … 238
I_DD total en régimen (oscilador + POR) | µA | 10,05 | 7,49 … 12,96 | 7,12 … 12,45

## 2 · Presupuesto de consumo

Corriente media de la fuente en régimen. Los bloques digitales se miden a 10 kHz (frecuencia de CLK); su consumo es dinámico y escala con la frecuencia.

Bloque | | Típico tt · 27 °C ·
1,20 V [µA] | tt: mín … máx [µA] ss: mín … máx [µA] Peor caso [µA]
wd_oscillater · bias | 2,64 | 1,93 … 3,44 | 1,81 … 3,28 | 3,44
wd_oscillater · comp_inf | 1,41 | 1,01 … 1,86 | 0,93 … 1,73 | 1,86
wd_oscillater · comp_sup | 2,83 | 2,06 … 3,71 | 1,92 … 3,50 | 3,71
wd_oscillater · divisor R1–R3 | 1,88 | 1,45 … 2,37 | 1,45 … 2,37 | 2,37
wd_oscillater · buf_1 → R4·C4 | 0,20 | 0,18 … 0,22 | 0,18 … 0,22 | 0,22
wd_oscillater · latch NOR + buf_4 (CLK, 200 fF) | 0,0020 | 0,0017 … 0,0059 | 0,0014 … 0,0029 | 0,0059
wd_oscillater (total) | | 8,97 | 6,64 … 11,60 | 6,29 … 11,11 | 11,60
wd_por · divisor R1–R2 | 0,54 | 0,42 … 0,69 | 0,42 … 0,69 | 0,69
wd_por · detector RL + MN | 0,53 | 0,42 … 0,65 | 0,41 … 0,63 | 0,65
wd_por · inv + and2 | 0,001 | 0,000 … 0,035 | 0,000 … 0,054 | 0,054
wd_por (total) | 1,08 | 0,85 … 1,36 | 0,83 … 1,32 | 1,36
wd_reset_sync (medio a 10 kHz) | 0,001 | 0,000 … 0,010 | 0,000 … 0,002 | 0,010
EN_INPUT (medio a 10 kHz) | 0,002 | 0,001 … 0,015 | 0,001 … 0,002 | 0,015
WDI_INPUT (medio a 10 kHz) | 0,002 | 0,001 … 0,015 | 0,001 … 0,002 | 0,015
Total de los bloques verificados | | 10,05 | 7,49 … 13,00 | 7,12 … 12,44 | 13,00
Integración medida (osc + POR, régimen) | 10,05 | 7,49 … 12,96 | 7,12 … 12,45 | 12,96

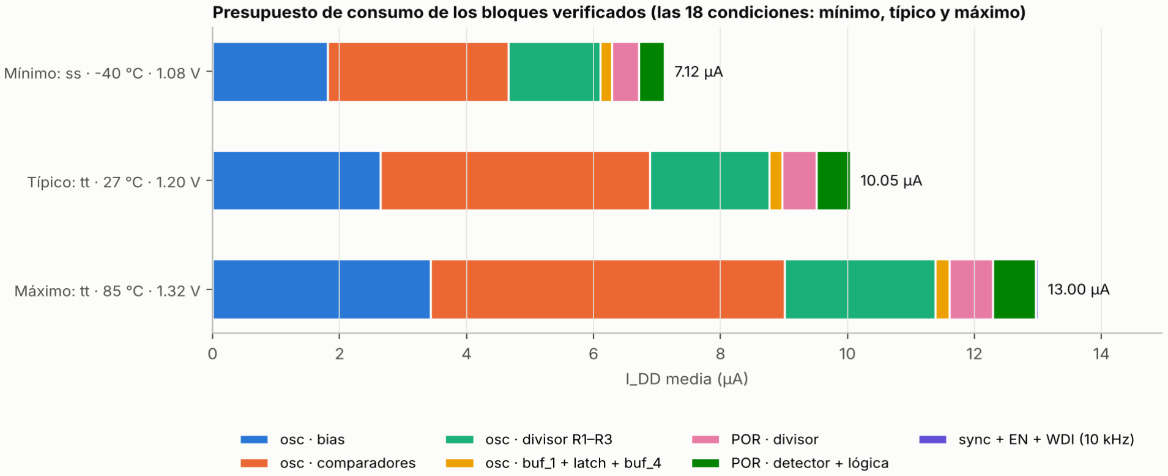
[picture p46: figure]

## 3 · Errores y márgenes

Magnitud | tt | ss | Lectura
Error de período vs 100 µs | −0,57 … 1,47 % | −0,49 … 1,46 % | Dentro de ± 2 %; la deriva viene de rhigh/rppd (TC) y del sobrepaso de VC.
Error de ciclo de trabajo vs 50 % | −0,13 … −0,01 pp | −0,14 … −0,02 pp | Simétrico: VH y VL equidistan de VDD/2.
Offset de comp_sup | −1,92 … −0,20 mV | −2,53 … −0,22 mV | Sin mismatch (corner global); Monte Carlo pendiente.
Offset de comp_inf | −0,10 … −0,05 mV | −0,10 mV | Ídem.
Sobrepaso de VC sobre VH | −0,49 … 1,68 mV | −0,52 … 1,72 mV | Retardo del comparador × pendiente de VC; aporta al error de período.
Sobrepaso de VC bajo VL | 1,68 … 2,55 mV | 1,77 … 2,41 mV | Ídem en la descarga.
Error de copia del espejo de bias | 8,3 … 15,3 % | 6,1 … 12,7 % | V_DS distinto en XM1 y XM3 (modulación de canal).

Margen POR: 1,08 V − VDD de

liberación | 341 … 352 mV | 183 … 209 mV | Positivo en todas las condiciones: libera antes de la VDD
| | | mínima.
Margen POR: VDD de liberación − 0,45 V | 278 … 289 mV | 421 … 447 mV | Lejos del piso donde la lógica deja de ser fiable.

VDD al liberar POR_B (integración,

rampa de 1 ms) | 0,840 … 0,957 V | 1,014 … 1,146 V | En ss supera 1,08 V en algunas condiciones: POR_B sale
| | | con el 2.º flanco de CLK, cuando la rampa ya pasó la VDD
| | | mínima.
Limitaciones: corners globales de MOS (tt, ss) con resistencias y capacitores típicos; sin mismatch local (los offsets reales serán mayores: falta Monte Carlo); sin parásitos de layout. En la integración, los FF del sincronizador se modelan en XSPICE (el FF real se valida aparte en wd_reset_sync). Precisión temporal del oscilador completo: el período cambia 0,1–0,4 % según el paso de simulación.

## Anexo A · Resultados por condición

Una fila por condición; la línea gruesa separa tt (arriba) de ss (abajo).

## A.1 · bias

Corner T [°C] | VDD
[V] | I_REF [µA] | I_OUT [µA] | I_DD [µA] | VBN [V] | V_SG [V] | Error espejo
[%] | t_est [µs]
tt | −40 | 1,08 | 0,92 | 1,01 | 1,93 | 0,331 | 0,504 | 10,0 | 0,87
tt | −40 | 1,20 | 1,06 | 1,19 | 2,25 | 0,338 | 0,517 | 12,9 | 0,77
tt | −40 | 1,32 | 1,20 | 1,38 | 2,57 | 0,345 | 0,529 | 15,3 | 0,69
tt | 27 | 1,08 | 1,09 | 1,19 | 2,28 | 0,314 | 0,502 | 9,1 | 0,74
tt | 27 | 1,20 | 1,25 | 1,39 | 2,64 | 0,324 | 0,517 | 11,2 | 0,66
tt | 27 | 1,32 | 1,41 | 1,59 | 3,00 | 0,332 | 0,531 | 13,0 | 0,59
tt | 85 | 1,08 | 1,27 | 1,38 | 2,65 | 0,302 | 0,496 | 8,3 | 0,62
tt | 85 | 1,20 | 1,45 | 1,59 | 3,04 | 0,313 | 0,513 | 10,0 | 0,54
tt | 85 | 1,32 | 1,63 | 1,81 | 3,44 | 0,324 | 0,528 | 11,4 | 0,38
ss | −40 | 1,08 | 0,87 | 0,94 | 1,81 | 0,367 | 0,545 | 7,0 | 1,00
ss | −40 | 1,20 | 1,01 | 1,11 | 2,13 | 0,375 | 0,558 | 10,0 | 0,88
ss | −40 | 1,32 | 1,15 | 1,30 | 2,45 | 0,382 | 0,571 | 12,7 | 0,78
ss | 27 | 1,08 | 1,04 | 1,11 | 2,15 | 0,350 | 0,544 | 6,5 | 0,85
ss | 27 | 1,20 | 1,20 | 1,31 | 2,50 | 0,360 | 0,559 | 8,9 | 0,75
ss | 27 | 1,32 | 1,36 | 1,50 | 2,86 | 0,369 | 0,574 | 10,9 | 0,68
ss | 85 | 1,08 | 1,21 | 1,29 | 2,50 | 0,337 | 0,538 | 6,1 | 0,73
ss | 85 | 1,20 | 1,39 | 1,50 | 2,89 | 0,349 | 0,556 | 8,0 | 0,64
ss | 85 | 1,32 | 1,57 | 1,72 | 3,28 | 0,360 | 0,572 | 9,5 | 0,58

## A.2 · schmitt

Corner T [°C] | VDD
[V] | V_T+ [V] | V_T− [V] | Hist. [mV] t_pHL [ps] t_pLH [ps] t_f [ps] | t_r [ps] | I pico DC
| | | | | | | | | | [µA] | E/ciclo [fJ]
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
ss | 27 | 1,32 | 0,874 | 1,106 | 2,28 | 236 | 10,91 | 9,73 | 1,19
ss | 85 | 1,08 | 0,897 | 1,039 | 2,26 | 238 | 9,66 | 8,60 | 1,06
ss | 85 | 1,20 | 0,897 | 1,095 | 2,27 | 238 | 11,03 | 9,85 | 1,18
ss | 85 | 1,32 | 0,897 | 1,146 | 2,27 | 238 | 12,45 | 11,13 | 1,32
