die-mirarchi/Watchdog-IHP-SG13G2/verification/testbenches/tb_wd_reset_sync.spice

** =====================================================================
** tb_wd_reset_sync.spice -- validacion de wd_reset_sync (IHP SG13G2, ngspice 42 + OSDI)
** DUT: dos sg13g2_dfrbp_1 en cadena, D(F1)=VDD, RESET_B = POR_RAW_N, PORB = Q(F2).
**   Pines del subcircuito: CLK POR_RAW_N PORB VDD VSS (ajustar al .sym que dibujes).
** Reloj: fuente ideal 10 kHz -> sg13g2_buf_4 (igual que XCLOCK del oscilador) -> 200 fF
**   (~25 entradas de reloj + cableado). Para el caso lento: buf_1 + 1 pF.
** Estimulo: 8 liberaciones de POR_RAW_N con fase delta respecto de un flanco de subida
**   de CLK (-50u, -1u, -100n, -10n, -1n, 0, +1n, +10n) y 8 aserciones a mitad de ciclo.
** CRITERIOS por liberacion (VEREDICTO al final del log):
**   - PORB sube SOLO en un flanco de subida de CLK (fase 0..20 ns despues del flanco);
**   - entre 1 y 2 periodos despues de la liberacion (2.o flanco; 3.o si se perdio el 1.o);
**   - P1 sube exactamente un periodo antes que PORB (+-20 ns);
**   - un solo flanco de subida de PORB (sin pulsos);
**   - asercion asincronica: PORB baja <= 100 ns despues de POR_RAW_N.
** NUMERICA: VBK no tiene efecto electrico; fuerza pasos de 25 ps alrededor de cada flanco.
**   Sin VBK, con tmax 10-50 ns el FF cambia en el flanco de BAJADA (artefacto: maestro y
**   esclavo conmutan en el mismo paso). Si cambias los tiempos, regenera VBK.
** Los mensajes "measure tG.. out of interval" son ESPERADOS (no hubo segundo flanco).
** =====================================================================
.lib cornerMOSlv.lib mos_tt
.lib cornerRES.lib res_typ
.lib cornerCAP.lib cap_typ
.include sg13g2_stdcell.spice
.temp 27
.param VH=1.2
.option method=gear maxord=2 reltol=1e-3

** DUT
.subckt wd_reset_sync CLK POR_RAW_N PORB VDD VSS
XF1 P1 P1_N CLK VDD POR_RAW_N VDD VSS sg13g2_dfrbp_1
XF2 PORB PORB_N CLK P1 POR_RAW_N VDD VSS sg13g2_dfrbp_1
.ends

* alimentacion: rampa de 10 us
VDD VDD 0 PWL(0 0 10u {VH})
VSS VSS 0 0
* reloj: fuente ideal 10 kHz (flancos de subida en 50u + k*100u) -> buffer del oscilador -> carga del arbol de reloj
VCK CKI 0 PULSE(0 {VH} 50u 2n 2n 50u 100u)
XCKB CLK CKI VDD VSS sg13g2_buf_4
CCLK CLK 0 200f
* POR_RAW_N: 8 liberaciones con fase delta respecto del flanco (150u + 300u*s): -50u -1u -100n -10n -1n 0 1n 10n
*            y 8 aserciones a mitad de ciclo (390u + 300u*s)
VPOR POR_RAW_N 0 PWL(0 0 0.0001 0 0.000100001 {VH} 0.00039 {VH} 0.000390001 0 0.000449 0
+ 0.000449001 {VH} 0.00069 {VH} 0.000690001 0 0.0007499 0 0.000749901 {VH} 0.00099 {VH}
+ 0.000990001 0 0.00104999 0 0.001049991 {VH} 0.00129 {VH} 0.001290001 0 0.001349999 0
+ 0.00135 {VH} 0.00159 {VH} 0.001590001 0 0.00165 0 0.001650001 {VH} 0.00189 {VH}
+ 0.001890001 0 0.001950001 0 0.001950002 {VH} 0.00219 {VH} 0.002190001 0 0.00225001 0
+ 0.002250011 {VH} 0.00249 {VH} 0.002490001 0)
XDUT CLK POR_RAW_N PORB VDD VSS wd_reset_sync
* VBK: fuente auxiliar SIN efecto electrico. Solo pone puntos de quiebre cada 25 ps alrededor de
* cada flanco de CLK y de POR_RAW_N (-1 ns..+3 ns). Sin esto, con paso de decenas de ns el maestro
* y el esclavo del FF conmutan en el mismo paso y PORB cambia en el flanco de BAJADA (artefacto numerico).
VBK BK 0 PWL(0 0 4.9999e-05 0.001 4.9999025e-05 0 4.999905e-05 0.001 4.9999075e-05 0 4.99991e-05 0.001 4.9999125e-05 0 4.999915e-05 0.001
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
let ok = ok & p6
* --- segmento 7: delta = 10n ---
let tP7=-1
let tQ7=-1
let tG7=-1
let tF7=-1
meas tran tP7 when v(porb)=VM rise=1 from=0.00225001 to=0.002485
meas tran tQ7 when v(xdut.p1)=VM rise=1 from=0.00225001 to=0.002485
meas tran tG7 when v(porb)=VM rise=2 from=0.00225001 to=0.002485
meas tran tF7 when v(porb)=VM fall=1 from=0.00249 to=0.002495
let d7 = (tP7 - 0.00225001)/T
let ph7 = (tP7 - 50u) - T*floor((tP7 - 50u)/T + 0.5)
let q7 = (tP7 - tQ7 - T)
let a7 = tF7 - 0.00249
let p7 = (tP7 gt 0) & (d7 ge 0.999) & (d7 le 2.0005) & (ph7 ge 0) & (ph7 le 20n) & (abs(q7) le 20n) & (tG7 lt 0) & (tF7 gt 0) & (a7 le 100n)
let ok = ok & p7
echo RESULT_BEGIN
print d0 d1 d2 d3 d4 d5 d6 d7
print ph0 ph1 ph2 ph3 ph4 ph5 ph6 ph7
print q0 q1 q2 q3 q4 q5 q6 q7
print a0 a1 a2 a3 a4 a5 a6 a7
print p0 p1 p2 p3 p4 p5 p6 p7 ok
echo RESULT_END
if ok > 0.5
  echo VEREDICTO: PASS
else
  echo VEREDICTO: FAIL
end
plot v(clk) v(por_raw_n) v(xdut.p1)+1.5 v(porb)+3
.endc
.end
