die-mirarchi/Watchdog-IHP-SG13G2/design/blocks/digital/schematic/simulation/wd_control.spice

** sch_path: /workspace/design/blocks/digital/schematic/wd_control.sch
**.subckt wd_control POR_B SET0 CLR T10 SET1 HI T01
*.ipin POR_B
*.ipin SET0
*.opin CLR
*.opin T10
*.ipin SET1
*.ipin HI
*.ipin T01
x1 CFG0 SET0 POR_B HI VDD VSS sg13g2_dllrq_1
x2 CFG1 SET1 POR_B HI VDD VSS sg13g2_dllrq_1
x4 DIS CFG0 CFG1 VDD VSS sg13g2_and2_2
x3 NBA WDI_EDGE ACTIVE NB VDD VSS sg13g2_a21o_1
x5 NBD NBA RS_N VDD VSS sg13g2_and2_1
x6 NB BOOT CLK NBD POR_B VDD VSS sg13g2_dfrbp_1
x7 OR3 DIS WDI_EDGE HIT VDD VSS sg13g2_or3_1
x8 net1 OR3 T01 RESET VDD VSS sg13g2_mux2_2
x9 CLR net1 VDD VSS sg13g2_buf_16
x10 TON T00 T01 T10 LO CFG0 CFG1 VDD VSS sg13g2_mux4_1
x11 TO T10 TON NB VDD VSS sg13g2_mux2_1
x12 HIT net2 TO WE_N VDD VSS sg13g2_and3_2
x13 WE_N WDI_EDGE VDD VSS sg13g2_inv_1
x14 net2 DIS RESET VDD VSS sg13g2_nor2_2
x15 RSD RESET Q10_N HIT VDD VSS sg13g2_a21o_1
x16 RESET RS_N CLK RSD POR_B VDD VSS sg13g2_dfrbp_2
**.ends

* expanding   symbol:  sg13g2_dllrq_1.sym # of pins=4
** sym_path: /foss/pdks/ihp-sg13g2/libs.ref/sg13g2_stdcell/sym/xschem/sg13g2_dllrq_1.sym
** sch_path: /foss/pdks/ihp-sg13g2/libs.ref/sg13g2_stdcell/sch/xschem/sg13g2_dllrq_1.sch
.subckt sg13g2_dllrq_1 Q D GATE_N RESET_B VDD VSS

*.ipin D
*.ipin GATE_N
*.ipin RESET_B
*.opin Q
XM1 gnb GATE_N VSS VSS sg13_lv_nmos w=740.00n l=130.00n ng=1 m=1 mm_ok=1
XM2 gnbb gnb VSS VSS sg13_lv_nmos w=740.00n l=130.00n ng=1 m=1 mm_ok=1
XM3 Db D VSS VSS sg13_lv_nmos w=550.00n l=130.00n ng=1 m=1 mm_ok=1
XM4 qint gnb net5 VSS sg13_lv_nmos w=640.00n l=130.00n ng=1 m=1 mm_ok=1
XM5 net5 Db VSS VSS sg13_lv_nmos w=640.00n l=130.00n ng=1 m=1 mm_ok=1
XM6 qint gnbb net1 VSS sg13_lv_nmos w=420.00n l=130.00n ng=1 m=1 mm_ok=1
XM7 net1 qint_b VSS VSS sg13_lv_nmos w=420.00n l=130.00n ng=1 m=1 mm_ok=1
XM8 qint_b qint net3 VSS sg13_lv_nmos w=740.00n l=130.00n ng=1 m=1 mm_ok=1
XM9 net3 RESET_B VSS VSS sg13_lv_nmos w=740.00n l=130.00n ng=1 m=1 mm_ok=1
XM10 Q qint_b VSS VSS sg13_lv_nmos w=740.00n l=130.00n ng=1 m=1 mm_ok=1
XM11 gnb GATE_N VDD VDD sg13_lv_pmos w=840.00n l=130.00n ng=1 m=1 mm_ok=1
XM12 gnbb gnb VDD VDD sg13_lv_pmos w=840.00n l=130.00n ng=1 m=1 mm_ok=1
XM13 Db D VDD VDD sg13_lv_pmos w=840.00n l=130.00n ng=1 m=1 mm_ok=1
XM14 net2 Db VDD VDD sg13_lv_pmos w=1.000u l=130.00n ng=1 m=1 mm_ok=1
XM15 qint gnbb net2 VDD sg13_lv_pmos w=1.000u l=130.00n ng=1 m=1 mm_ok=1
XM16 net4 qint_b VDD VDD sg13_lv_pmos w=420.00n l=130.00n ng=1 m=1 mm_ok=1
XM17 qint gnb net4 VDD sg13_lv_pmos w=420.00n l=130.00n ng=1 m=1 mm_ok=1
XM18 qint_b qint VDD VDD sg13_lv_pmos w=1.000u l=130.00n ng=1 m=1 mm_ok=1
XM19 qint_b RESET_B VDD VDD sg13_lv_pmos w=1.000u l=130.00n ng=1 m=1 mm_ok=1
XM20 Q qint_b VDD VDD sg13_lv_pmos w=1.12u l=130.00n ng=1 m=1 mm_ok=1
.ends


* expanding   symbol:  sg13g2_and2_2.sym # of pins=3
** sym_path: /foss/pdks/ihp-sg13g2/libs.ref/sg13g2_stdcell/sym/xschem/sg13g2_and2_2.sym
** sch_path: /foss/pdks/ihp-sg13g2/libs.ref/sg13g2_stdcell/sch/xschem/sg13g2_and2_2.sch
.subckt sg13g2_and2_2 X A B VDD VSS

*.ipin A
*.ipin B
*.opin X
XM1 net1 A net2 VSS sg13_lv_nmos w=640.00n l=130.00n ng=1 m=1 mm_ok=1
XM2 net2 B VSS VSS sg13_lv_nmos w=640.00n l=130.00n ng=1 m=1 mm_ok=1
XM3 X net1 VSS VSS sg13_lv_nmos w=1.48u l=130.00n ng=2 m=1 mm_ok=1
XM4 net1 B VDD VDD sg13_lv_pmos w=840.00n l=130.00n ng=1 m=1 mm_ok=1
XM5 net1 A VDD VDD sg13_lv_pmos w=840.00n l=130.00n ng=1 m=1 mm_ok=1
XM6 X net1 VDD VDD sg13_lv_pmos w=2.24u l=130.00n ng=2 m=1 mm_ok=1
.ends


* expanding   symbol:  sg13g2_a21o_1.sym # of pins=4
** sym_path: /foss/pdks/ihp-sg13g2/libs.ref/sg13g2_stdcell/sym/xschem/sg13g2_a21o_1.sym
** sch_path: /foss/pdks/ihp-sg13g2/libs.ref/sg13g2_stdcell/sch/xschem/sg13g2_a21o_1.sch
.subckt sg13g2_a21o_1 X A1 A2 B1 VDD VSS

*.opin X
*.ipin A1
*.ipin A2
*.ipin B1
XM1 net1 A1 net3 VSS sg13_lv_nmos w=640.00n l=130.00n ng=1 m=1 mm_ok=1
XM2 net3 A2 VSS VSS sg13_lv_nmos w=640.00n l=130.00n ng=1 m=1 mm_ok=1
XM3 net1 B1 VSS VSS sg13_lv_nmos w=640.00n l=130.00n ng=1 m=1 mm_ok=1
XM4 X net1 VSS VSS sg13_lv_nmos w=740.00n l=130.00n ng=1 m=1 mm_ok=1
XM5 net2 A1 VDD VDD sg13_lv_pmos w=1.000u l=130.00n ng=1 m=1 mm_ok=1
XM6 net2 A2 VDD VDD sg13_lv_pmos w=1.000u l=130.00n ng=1 m=1 mm_ok=1
XM7 net1 B1 net2 VDD sg13_lv_pmos w=1.000u l=130.00n ng=1 m=1 mm_ok=1
XM8 X net1 VDD VDD sg13_lv_pmos w=1.12u l=130.00n ng=1 m=1 mm_ok=1
.ends


* expanding   symbol:  sg13g2_and2_1.sym # of pins=3
** sym_path: /foss/pdks/ihp-sg13g2/libs.ref/sg13g2_stdcell/sym/xschem/sg13g2_and2_1.sym
** sch_path: /foss/pdks/ihp-sg13g2/libs.ref/sg13g2_stdcell/sch/xschem/sg13g2_and2_1.sch
.subckt sg13g2_and2_1 X A B VDD VSS

*.ipin A
*.ipin B
*.opin X
XM1 net1 A net2 VSS sg13_lv_nmos w=640.00n l=130.00n ng=1 m=1 mm_ok=1
XM2 net2 B VSS VSS sg13_lv_nmos w=640.00n l=130.00n ng=1 m=1 mm_ok=1
XM3 X net1 VSS VSS sg13_lv_nmos w=740.00n l=130.00n ng=1 m=1 mm_ok=1
XM4 net1 B VDD VDD sg13_lv_pmos w=840.00n l=130.00n ng=1 m=1 mm_ok=1
XM5 net1 A VDD VDD sg13_lv_pmos w=840.00n l=130.00n ng=1 m=1 mm_ok=1
XM6 X net1 VDD VDD sg13_lv_pmos w=1.12u l=130.00n ng=1 m=1 mm_ok=1
.ends


* expanding   symbol:  sg13g2_dfrbp_1.sym # of pins=5
** sym_path: /foss/pdks/ihp-sg13g2/libs.ref/sg13g2_stdcell/sym/xschem/sg13g2_dfrbp_1.sym
** sch_path: /foss/pdks/ihp-sg13g2/libs.ref/sg13g2_stdcell/sch/xschem/sg13g2_dfrbp_1.sch
.subckt sg13g2_dfrbp_1 Q Q_N CLK D RESET_B VDD VSS

*.ipin D
*.ipin RESET_B
*.ipin CLK
*.opin Q
*.opin Q_N
XM1 Db D net12 VSS sg13_lv_nmos w=420.00n l=130.00n ng=1 m=1 mm_ok=1
XM2 net12 RESET_B VSS VSS sg13_lv_nmos w=420.00n l=130.00n ng=1 m=1 mm_ok=1
XM3 net2 clkneg net11 VSS sg13_lv_nmos w=420.00n l=130.00n ng=1 m=1 mm_ok=1
XM4 net11 net1 VSS VSS sg13_lv_nmos w=420.00n l=130.00n ng=1 m=1 mm_ok=1
XM5 net1 net2 net7 VSS sg13_lv_nmos w=420.00n l=130.00n ng=1 m=1 mm_ok=1
XM6 net7 RESET_B VSS VSS sg13_lv_nmos w=420.00n l=130.00n ng=1 m=1 mm_ok=1
XM7 Q_N net2 VSS VSS sg13_lv_nmos w=740.00n l=130.00n ng=1 m=1 mm_ok=1
XM8 net3 net2 VSS VSS sg13_lv_nmos w=740.00n l=130.00n ng=1 m=1 mm_ok=1
XM9 Q net3 VSS VSS sg13_lv_nmos w=740.00n l=130.00n ng=1 m=1 mm_ok=1
XM10 clkneg CLK VSS VSS sg13_lv_nmos w=740.00n l=130.00n ng=1 m=1 mm_ok=1
XM11 clkpos clkneg VSS VSS sg13_lv_nmos w=740.00n l=130.00n ng=1 m=1 mm_ok=1
XM12 Db clkneg net5 VSS sg13_lv_nmos w=420.00n l=130.00n ng=1 m=1 mm_ok=1
XM13 net5 clkpos net10 VSS sg13_lv_nmos w=420.00n l=130.00n ng=1 m=1 mm_ok=1
XM14 net10 net4 net6 VSS sg13_lv_nmos w=420.00n l=130.00n ng=1 m=1 mm_ok=1
XM15 net6 RESET_B VSS VSS sg13_lv_nmos w=420.00n l=130.00n ng=1 m=1 mm_ok=1
XM16 net4 net5 VSS VSS sg13_lv_nmos w=740.00n l=130.00n ng=1 m=1 mm_ok=1
XM17 net4 clkpos net2 VSS sg13_lv_nmos w=740.00n l=130.00n ng=1 m=1 mm_ok=1
XM18 Db RESET_B VDD VDD sg13_lv_pmos w=420.00n l=130.00n ng=1 m=1 mm_ok=1
XM19 Db D VDD VDD sg13_lv_pmos w=420.00n l=130.00n ng=1 m=1 mm_ok=1
XM20 net9 net1 VDD VDD sg13_lv_pmos w=420.00n l=130.00n ng=1 m=1 mm_ok=1
XM21 net2 clkpos net9 VDD sg13_lv_pmos w=420.00n l=130.00n ng=1 m=1 mm_ok=1
XM22 net1 net2 VDD VDD sg13_lv_pmos w=420.00n l=130.00n ng=1 m=1 mm_ok=1
XM23 net1 RESET_B VDD VDD sg13_lv_pmos w=420.00n l=130.00n ng=1 m=1 mm_ok=1
XM24 Q_N net2 VDD VDD sg13_lv_pmos w=1.12u l=130.00n ng=1 m=1 mm_ok=1
XM25 net3 net2 VDD VDD sg13_lv_pmos w=1.12u l=130.00n ng=1 m=1 mm_ok=1
XM26 Q net3 VDD VDD sg13_lv_pmos w=1.12u l=130.00n ng=1 m=1 mm_ok=1
XM27 clkneg CLK VDD VDD sg13_lv_pmos w=1.12u l=130.00n ng=1 m=1 mm_ok=1
XM28 clkpos clkneg VDD VDD sg13_lv_pmos w=1.12u l=130.00n ng=1 m=1 mm_ok=1
XM29 Db clkpos net5 VDD sg13_lv_pmos w=420.00n l=130.00n ng=1 m=1 mm_ok=1
XM30 net8 net4 VDD VDD sg13_lv_pmos w=420.00n l=130.00n ng=1 m=1 mm_ok=1
XM31 net5 clkneg net8 VDD sg13_lv_pmos w=420.00n l=130.00n ng=1 m=1 mm_ok=1
XM32 net5 RESET_B VDD VDD sg13_lv_pmos w=420.00n l=130.00n ng=1 m=1 mm_ok=1
XM33 net4 net5 VDD VDD sg13_lv_pmos w=1.000u l=130.00n ng=1 m=1 mm_ok=1
XM34 net4 clkneg net2 VDD sg13_lv_pmos w=1.000u l=130.00n ng=1 m=1 mm_ok=1
.ends


* expanding   symbol:  sg13g2_or3_1.sym # of pins=4
** sym_path: /foss/pdks/ihp-sg13g2/libs.ref/sg13g2_stdcell/sym/xschem/sg13g2_or3_1.sym
** sch_path: /foss/pdks/ihp-sg13g2/libs.ref/sg13g2_stdcell/sch/xschem/sg13g2_or3_1.sch
.subckt sg13g2_or3_1 X A B C VDD VSS

*.opin X
*.ipin C
*.ipin B
*.ipin A
XM1 net2 A VSS VSS sg13_lv_nmos w=550.00n l=130.00n ng=1 m=1 mm_ok=1
XM2 net2 B VSS VSS sg13_lv_nmos w=550.00n l=130.00n ng=1 m=1 mm_ok=1
XM3 net2 C VSS VSS sg13_lv_nmos w=550.00n l=130.00n ng=1 m=1 mm_ok=1
XM4 X net2 VSS VSS sg13_lv_nmos w=740.00n l=130.00n ng=1 m=1 mm_ok=1
XM5 net1 A VDD VDD sg13_lv_pmos w=1.000u l=130.00n ng=1 m=1 mm_ok=1
XM6 net3 B net1 VDD sg13_lv_pmos w=1.000u l=130.00n ng=1 m=1 mm_ok=1
XM7 net2 C net3 VDD sg13_lv_pmos w=1.000u l=130.00n ng=1 m=1 mm_ok=1
XM8 X net2 VDD VDD sg13_lv_pmos w=1.12u l=130.00n ng=1 m=1 mm_ok=1
.ends


* expanding   symbol:  sg13g2_mux2_2.sym # of pins=4
** sym_path: /foss/pdks/ihp-sg13g2/libs.ref/sg13g2_stdcell/sym/xschem/sg13g2_mux2_2.sym
** sch_path: /foss/pdks/ihp-sg13g2/libs.ref/sg13g2_stdcell/sch/xschem/sg13g2_mux2_2.sch
.subckt sg13g2_mux2_2 X A0 A1 S VDD VSS

*.ipin S
*.ipin A0
*.ipin A1
*.opin X
XM1 Sb S VSS VSS sg13_lv_nmos w=550.00n l=130.00n ng=1 m=1 mm_ok=1
XM2 net1 A0 net5 VSS sg13_lv_nmos w=740.00n l=130.00n ng=1 m=1 mm_ok=1
XM3 net5 Sb VSS VSS sg13_lv_nmos w=740.00n l=130.00n ng=1 m=1 mm_ok=1
XM4 net1 A1 net4 VSS sg13_lv_nmos w=740.00n l=130.00n ng=1 m=1 mm_ok=1
XM5 net4 S VSS VSS sg13_lv_nmos w=740.00n l=130.00n ng=1 m=1 mm_ok=1
XM6 X net1 VSS VSS sg13_lv_nmos w=1.48u l=130.00n ng=2 m=1 mm_ok=1
XM7 Sb S VDD VDD sg13_lv_pmos w=840.00n l=130.00n ng=1 m=1 mm_ok=1
XM8 net2 S VDD VDD sg13_lv_pmos w=1.000u l=130.00n ng=1 m=1 mm_ok=1
XM9 net1 A0 net2 VDD sg13_lv_pmos w=1.000u l=130.00n ng=1 m=1 mm_ok=1
XM10 net3 Sb VDD VDD sg13_lv_pmos w=1.000u l=130.00n ng=1 m=1 mm_ok=1
XM11 net1 A1 net3 VDD sg13_lv_pmos w=1.000u l=130.00n ng=1 m=1 mm_ok=1
XM12 X net1 VDD VDD sg13_lv_pmos w=2.24u l=130.00n ng=2 m=1 mm_ok=1
.ends


* expanding   symbol:  sg13g2_buf_16.sym # of pins=2
** sym_path: /foss/pdks/ihp-sg13g2/libs.ref/sg13g2_stdcell/sym/xschem/sg13g2_buf_16.sym
** sch_path: /foss/pdks/ihp-sg13g2/libs.ref/sg13g2_stdcell/sch/xschem/sg13g2_buf_16.sch
.subckt sg13g2_buf_16 X A VDD VSS

*.ipin A
*.opin X
XM1 net1 A VSS VSS sg13_lv_nmos w=4.44u l=130.00n ng=6 m=1 mm_ok=1
XM2 X net1 VSS VSS sg13_lv_nmos w=11.84u l=130.00n ng=16 m=1 mm_ok=1
XM3 net1 A VDD VDD sg13_lv_pmos w=6.72u l=130.00n ng=6 m=1 mm_ok=1
XM4 X net1 VDD VDD sg13_lv_pmos w=17.92u l=130.00n ng=16 m=1 mm_ok=1
.ends


* expanding   symbol:  sg13g2_mux4_1.sym # of pins=7
** sym_path: /foss/pdks/ihp-sg13g2/libs.ref/sg13g2_stdcell/sym/xschem/sg13g2_mux4_1.sym
** sch_path: /foss/pdks/ihp-sg13g2/libs.ref/sg13g2_stdcell/sch/xschem/sg13g2_mux4_1.sch
.subckt sg13g2_mux4_1 X A0 A1 A2 A3 S0 S1 VDD VSS

*.ipin S0
*.ipin S1
*.ipin A0
*.ipin A1
*.ipin A2
*.ipin A3
*.opin X
XM1 S0b S0 VSS VSS sg13_lv_nmos w=640.00n l=130.00n ng=1 m=1 mm_ok=1
XM2 S1b S1 VSS VSS sg13_lv_nmos w=640.00n l=130.00n ng=1 m=1 mm_ok=1
XM3 net4 A3 VSS VSS sg13_lv_nmos w=640.00n l=130.00n ng=1 m=1 mm_ok=1
XM4 high S1 Xb VSS sg13_lv_nmos w=640.00n l=130.00n ng=1 m=1 mm_ok=1
XM5 X Xb VSS VSS sg13_lv_nmos w=740.00n l=130.00n ng=1 m=1 mm_ok=1
XM6 low S0b net7 VSS sg13_lv_nmos w=640.00n l=130.00n ng=1 m=1 mm_ok=1
XM7 net7 A0 VSS VSS sg13_lv_nmos w=640.00n l=130.00n ng=1 m=1 mm_ok=1
XM8 low S0 net2 VSS sg13_lv_nmos w=640.00n l=130.00n ng=1 m=1 mm_ok=1
XM9 net2 A1 VSS VSS sg13_lv_nmos w=640.00n l=130.00n ng=1 m=1 mm_ok=1
XM10 low S1b Xb VSS sg13_lv_nmos w=640.00n l=130.00n ng=1 m=1 mm_ok=1
XM11 high S0b net6 VSS sg13_lv_nmos w=640.00n l=130.00n ng=1 m=1 mm_ok=1
XM12 net6 A2 VSS VSS sg13_lv_nmos w=640.00n l=130.00n ng=1 m=1 mm_ok=1
XM13 high S0 net4 VSS sg13_lv_nmos w=640.00n l=130.00n ng=1 m=1 mm_ok=1
XM14 S0b S0 VDD VDD sg13_lv_pmos w=1.000u l=130.00n ng=1 m=1 mm_ok=1
XM15 S1b S1 VDD VDD sg13_lv_pmos w=1.000u l=130.00n ng=1 m=1 mm_ok=1
XM16 high S0b net3 VDD sg13_lv_pmos w=1.000u l=130.00n ng=1 m=1 mm_ok=1
XM17 high S1b Xb VDD sg13_lv_pmos w=1.000u l=130.00n ng=1 m=1 mm_ok=1
XM18 X Xb VDD VDD sg13_lv_pmos w=1.12u l=130.00n ng=1 m=1 mm_ok=1
XM19 net8 A0 VDD VDD sg13_lv_pmos w=1.000u l=130.00n ng=1 m=1 mm_ok=1
XM20 low S0 net8 VDD sg13_lv_pmos w=1.000u l=130.00n ng=1 m=1 mm_ok=1
XM21 net1 A1 VDD VDD sg13_lv_pmos w=1.000u l=130.00n ng=1 m=1 mm_ok=1
XM22 low S0b net1 VDD sg13_lv_pmos w=1.000u l=130.00n ng=1 m=1 mm_ok=1
XM23 low S1 Xb VDD sg13_lv_pmos w=1.000u l=130.00n ng=1 m=1 mm_ok=1
XM24 net5 A2 VDD VDD sg13_lv_pmos w=1.000u l=130.00n ng=1 m=1 mm_ok=1
XM25 high S0 net5 VDD sg13_lv_pmos w=1.000u l=130.00n ng=1 m=1 mm_ok=1
XM26 net3 A3 VDD VDD sg13_lv_pmos w=1.000u l=130.00n ng=1 m=1 mm_ok=1
.ends


* expanding   symbol:  sg13g2_mux2_1.sym # of pins=4
** sym_path: /foss/pdks/ihp-sg13g2/libs.ref/sg13g2_stdcell/sym/xschem/sg13g2_mux2_1.sym
** sch_path: /foss/pdks/ihp-sg13g2/libs.ref/sg13g2_stdcell/sch/xschem/sg13g2_mux2_1.sch
.subckt sg13g2_mux2_1 X A0 A1 S VDD VSS

*.ipin S
*.ipin A0
*.ipin A1
*.opin X
XM1 Sb S VSS VSS sg13_lv_nmos w=550.00n l=130.00n ng=1 m=1 mm_ok=1
XM2 net1 A0 net5 VSS sg13_lv_nmos w=740.00n l=130.00n ng=1 m=1 mm_ok=1
XM3 net5 Sb VSS VSS sg13_lv_nmos w=740.00n l=130.00n ng=1 m=1 mm_ok=1
XM4 net1 A1 net4 VSS sg13_lv_nmos w=740.00n l=130.00n ng=1 m=1 mm_ok=1
XM5 net4 S VSS VSS sg13_lv_nmos w=740.00n l=130.00n ng=1 m=1 mm_ok=1
XM6 X net1 VSS VSS sg13_lv_nmos w=740.00n l=130.00n ng=1 m=1 mm_ok=1
XM7 Sb S VDD VDD sg13_lv_pmos w=840.00n l=130.00n ng=1 m=1 mm_ok=1
XM8 net2 S VDD VDD sg13_lv_pmos w=1.000u l=130.00n ng=1 m=1 mm_ok=1
XM9 net1 A0 net2 VDD sg13_lv_pmos w=1.000u l=130.00n ng=1 m=1 mm_ok=1
XM10 net3 Sb VDD VDD sg13_lv_pmos w=1.000u l=130.00n ng=1 m=1 mm_ok=1
XM11 net1 A1 net3 VDD sg13_lv_pmos w=1.000u l=130.00n ng=1 m=1 mm_ok=1
XM12 X net1 VDD VDD sg13_lv_pmos w=1.12u l=130.00n ng=1 m=1 mm_ok=1
.ends


* expanding   symbol:  sg13g2_and3_2.sym # of pins=4
** sym_path: /foss/pdks/ihp-sg13g2/libs.ref/sg13g2_stdcell/sym/xschem/sg13g2_and3_2.sym
** sch_path: /foss/pdks/ihp-sg13g2/libs.ref/sg13g2_stdcell/sch/xschem/sg13g2_and3_2.sch
.subckt sg13g2_and3_2 X A B C VDD VSS

*.opin X
*.ipin C
*.ipin B
*.ipin A
XM1 net1 A net3 VSS sg13_lv_nmos w=640.00n l=130.00n ng=1 m=1 mm_ok=1
XM2 net3 B net2 VSS sg13_lv_nmos w=640.00n l=130.00n ng=1 m=1 mm_ok=1
XM3 net2 C VSS VSS sg13_lv_nmos w=640.00n l=130.00n ng=1 m=1 mm_ok=1
XM4 X net1 VSS VSS sg13_lv_nmos w=1.48u l=130.00n ng=2 m=1 mm_ok=1
XM5 net1 C VDD VDD sg13_lv_pmos w=840.00n l=130.00n ng=1 m=1 mm_ok=1
XM6 net1 B VDD VDD sg13_lv_pmos w=840.00n l=130.00n ng=1 m=1 mm_ok=1
XM7 net1 A VDD VDD sg13_lv_pmos w=840.00n l=130.00n ng=1 m=1 mm_ok=1
XM8 X net1 VDD VDD sg13_lv_pmos w=2.24u l=130.00n ng=2 m=1 mm_ok=1
.ends


* expanding   symbol:  sg13g2_inv_1.sym # of pins=2
** sym_path: /foss/pdks/ihp-sg13g2/libs.ref/sg13g2_stdcell/sym/xschem/sg13g2_inv_1.sym
** sch_path: /foss/pdks/ihp-sg13g2/libs.ref/sg13g2_stdcell/sch/xschem/sg13g2_inv_1.sch
.subckt sg13g2_inv_1 Y A VDD VSS

*.opin Y
*.ipin A
XM1 Y A VSS VSS sg13_lv_nmos w=740.00n l=130.00n ng=1 m=1 mm_ok=1
XM2 Y A VDD VDD sg13_lv_pmos w=1.12u l=130.00n ng=1 m=1 mm_ok=1
.ends


* expanding   symbol:  sg13g2_nor2_2.sym # of pins=3
** sym_path: /foss/pdks/ihp-sg13g2/libs.ref/sg13g2_stdcell/sym/xschem/sg13g2_nor2_2.sym
** sch_path: /foss/pdks/ihp-sg13g2/libs.ref/sg13g2_stdcell/sch/xschem/sg13g2_nor2_2.sch
.subckt sg13g2_nor2_2 Y A B VDD VSS

*.opin Y
*.ipin B
*.ipin A
XM1 Y A VSS VSS sg13_lv_nmos w=1.48u l=130.00n ng=2 m=1 mm_ok=1
XM2 Y B VSS VSS sg13_lv_nmos w=1.48u l=130.00n ng=2 m=1 mm_ok=1
XM3 net1 A VDD VDD sg13_lv_pmos w=2.24u l=130.00n ng=2 m=1 mm_ok=1
XM4 Y B net1 VDD sg13_lv_pmos w=2.24u l=130.00n ng=2 m=1 mm_ok=1
.ends


* expanding   symbol:  sg13g2_dfrbp_2.sym # of pins=5
** sym_path: /foss/pdks/ihp-sg13g2/libs.ref/sg13g2_stdcell/sym/xschem/sg13g2_dfrbp_2.sym
** sch_path: /foss/pdks/ihp-sg13g2/libs.ref/sg13g2_stdcell/sch/xschem/sg13g2_dfrbp_2.sch
.subckt sg13g2_dfrbp_2 Q Q_N CLK D RESET_B VDD VSS

*.ipin D
*.ipin RESET_B
*.ipin CLK
*.opin Q
*.opin Q_N
XM1 Db D net12 VSS sg13_lv_nmos w=420.00n l=130.00n ng=1 m=1 mm_ok=1
XM2 net12 RESET_B VSS VSS sg13_lv_nmos w=420.00n l=130.00n ng=1 m=1 mm_ok=1
XM3 net2 clkneg net11 VSS sg13_lv_nmos w=420.00n l=130.00n ng=1 m=1 mm_ok=1
XM4 net11 net3 VSS VSS sg13_lv_nmos w=420.00n l=130.00n ng=1 m=1 mm_ok=1
XM5 net3 net2 net7 VSS sg13_lv_nmos w=420.00n l=130.00n ng=1 m=1 mm_ok=1
XM6 net7 RESET_B VSS VSS sg13_lv_nmos w=420.00n l=130.00n ng=1 m=1 mm_ok=1
XM7 Q_N net2 VSS VSS sg13_lv_nmos w=1.48u l=130.00n ng=2 m=1 mm_ok=1
XM8 net1 net2 VSS VSS sg13_lv_nmos w=640.00n l=130.00n ng=1 m=1 mm_ok=1
XM9 Q net1 VSS VSS sg13_lv_nmos w=1.48u l=130.00n ng=2 m=1 mm_ok=1
XM10 clkneg CLK VSS VSS sg13_lv_nmos w=740.00n l=130.00n ng=1 m=1 mm_ok=1
XM11 clkpos clkneg VSS VSS sg13_lv_nmos w=740.00n l=130.00n ng=1 m=1 mm_ok=1
XM12 Db clkneg net4 VSS sg13_lv_nmos w=420.00n l=130.00n ng=1 m=1 mm_ok=1
XM13 net4 clkpos net10 VSS sg13_lv_nmos w=420.00n l=130.00n ng=1 m=1 mm_ok=1
XM14 net10 net5 net6 VSS sg13_lv_nmos w=420.00n l=130.00n ng=1 m=1 mm_ok=1
XM15 net6 RESET_B VSS VSS sg13_lv_nmos w=420.00n l=130.00n ng=1 m=1 mm_ok=1
XM16 net5 net4 VSS VSS sg13_lv_nmos w=740.00n l=130.00n ng=1 m=1 mm_ok=1
XM17 net5 clkpos net2 VSS sg13_lv_nmos w=740.00n l=130.00n ng=1 m=1 mm_ok=1
XM18 Db RESET_B VDD VDD sg13_lv_pmos w=420.00n l=130.00n ng=1 m=1 mm_ok=1
XM19 Db D VDD VDD sg13_lv_pmos w=420.00n l=130.00n ng=1 m=1 mm_ok=1
XM20 net9 net3 VDD VDD sg13_lv_pmos w=420.00n l=130.00n ng=1 m=1 mm_ok=1
XM21 net2 clkpos net9 VDD sg13_lv_pmos w=420.00n l=130.00n ng=1 m=1 mm_ok=1
XM22 net3 net2 VDD VDD sg13_lv_pmos w=420.00n l=130.00n ng=1 m=1 mm_ok=1
XM23 net3 RESET_B VDD VDD sg13_lv_pmos w=420.00n l=130.00n ng=1 m=1 mm_ok=1
XM24 Q_N net2 VDD VDD sg13_lv_pmos w=2.24u l=130.00n ng=2 m=1 mm_ok=1
XM25 net1 net2 VDD VDD sg13_lv_pmos w=1.000u l=130.00n ng=1 m=1 mm_ok=1
XM26 Q net1 VDD VDD sg13_lv_pmos w=2.24u l=130.00n ng=2 m=1 mm_ok=1
XM27 clkneg CLK VDD VDD sg13_lv_pmos w=1.12u l=130.00n ng=1 m=1 mm_ok=1
XM28 clkpos clkneg VDD VDD sg13_lv_pmos w=1.12u l=130.00n ng=1 m=1 mm_ok=1
XM29 Db clkpos net4 VDD sg13_lv_pmos w=420.00n l=130.00n ng=1 m=1 mm_ok=1
XM30 net8 net5 VDD VDD sg13_lv_pmos w=420.00n l=130.00n ng=1 m=1 mm_ok=1
XM31 net4 clkneg net8 VDD sg13_lv_pmos w=420.00n l=130.00n ng=1 m=1 mm_ok=1
XM32 net4 RESET_B VDD VDD sg13_lv_pmos w=420.00n l=130.00n ng=1 m=1 mm_ok=1
XM33 net5 net4 VDD VDD sg13_lv_pmos w=1.000u l=130.00n ng=1 m=1 mm_ok=1
XM34 net5 clkneg net2 VDD sg13_lv_pmos w=1.000u l=130.00n ng=1 m=1 mm_ok=1
.ends

.end
