die-mirarchi/Watchdog-IHP-SG13G2/(commit log)

2026-10-05 Prepare clean reproducible IHP watchdog thesis workspace
    [tb_count4bits.sch, tb_inverter.sch]
2026-10-05 Add EN Input with testbench
    [EN_INPUT.sch, EN_INPUT_tb.sch]
2026-11-06 power on reset
2026-11-06 Change nmos in power on reset
    from 1/4 to 0.3/9.9
2026-11-06 reset sync schematic
2026-11-06 Labels en nets internas, FF de tamaño 1 y N_POR -> POR_B
2026-11-12 Counter de 17 bits
2026-11-12 Agregar testebenches y verificacion de control y contador
